AishuaiYao/AICleanBot/ROADMAP.md

# Roadmap

这个项目**没有做完**。V1 已经能跑，后续因为硬件资金等原因暂停。
路线图写在这里，任何一段都欢迎接手 —— 想认领请开一个 issue 说明你打算做哪块。

状态说明：✅ 已实现 · 🚧 进行中 · 📋 计划中 · 💭 构想

---

## V1 · 视觉巡线 ✅

目标：一块 ESP32-S3 独立完成「看线 → 沿走」。

- [x] OV2640 160×120 灰度采集，PSRAM 帧缓冲
- [x] ESP-DL 加载 INT8 模型，逐像素二分类
- [x] Sigmoid 查表后处理（256 项 LUT，零浮点）
- [x] 双质心 G1 / G2 提取，抗单点噪声
- [x] PID 差速控制，Kp 运行时可调
- [x] 连续丢线 5 帧自动停车
- [x] 编码器 PCNT 计数 + 滑动窗口掉速碰撞检测
- [x] 电池电压 ADC 采样
- [x] 呼吸灯状态指示
- [x] TCP 命令通道 + UDP 视频流
- [x] 实验模式：分割叠加图 + 遥测回传（19210B 定长帧）
- [x] 双分区 OTA 空中升级

**训练侧**

- [x] 完整数据采集 → 标注 → 划分 → 训练 → 量化 → 部署链路
- [x] 教师模型 U-Net + ResNet18
- [x] 学生模型 7 个变体（`UNetMiniExp1`~`7`）
- [x] 知识蒸馏（α=0.6, T=4.0）
- [x] ONNX 导出 + ESP-PPQ INT8 量化
- [x] 板端推理验证工具

**上位机**

- [x] 微信小程序：设备发现、握手、实时视频、遥控
- [x] 本地 / 云端数据集管理
- [x] 编码器数据记录与柱状图导出

---

## V1.1 · 清洁机构 ✅

- [x] 3 号电机独立 PWM 通道（GPIO45）
- [x] 毛刷 / 吸水辊结构
- [x] 水箱建模（`hardware/cad/water-tank.stl`）
- [x] 外壳、底盘结构件（毫米单位，可直接切片）

**遗留**

- [ ] 水箱水密性长期验证（PLA 会缓慢降解，需换 PETG 或涂层）
- [ ] 清洁电机的堵转保护

---

## V2 · 地图与导航 🚧

目标：从「跟着一条线走」升级到「知道自己在哪、还没扫过哪」。

- [ ] DFS 全覆盖遍历移植到板端 C++（原型：`py_scripts/simulation/dfs.py`）
- [ ] 栅格地图构建（10×10 → 可配置尺寸）
- [ ] 里程计：编码器 + 陀螺仪融合
- [ ] 路口识别（原型：`py_scripts/simulation/classification.py` 的端点扫描法）
- [ ] 回到未覆盖区域的重入策略

**难点**：双轮差速 + 单编码器一倍频的里程计漂移很大，需要引入 IMU 做融合。

---

## V3 · 自主清扫 📋

- [ ] 覆盖路径规划（弓字形 / 螺旋，按房间形状切换）
- [ ] 边界与悬崖检测
- [ ] 回充对接（红外 / 视觉）
- [ ] 清扫状态机：清扫 → 返回 → 充电 → 续扫
- [ ] 电量低自动返航

---

## V4 · 更强的 AI 💭

- [ ] 多类别分割：地面材质 / 障碍物 / 充电桩 / 地毯
- [ ] 端侧多任务模型（分割 + 分类共享 backbone）
- [ ] 自监督预训练，减少标注成本
- [ ] 模型热切换（不同地面用不同权重）

---

## 工程化 📋

这些不改变功能，但决定别人能不能顺利参与。

- [ ] WiFi SSID / 密码、PID 增益迁移到 `menuconfig`（`main/Kconfig.projbuild`）
- [ ] 模型改存 SPIFFS，换模型不用重新烧固件
- [ ] GitHub Actions：固件自动编译（多目标 esp32s3 / esp32p4）
- [ ] GitHub Actions：训练脚本冒烟测试（1 epoch 小数据集）
- [ ] 单元测试：`tools.py` 的路径处理、数据集划分
- [ ] 英文 README
- [ ] 拆解与装配视频教程

---

## 需要外部支持

| 需求 | 说明 |
|---|---|
| PCB 打样 / 贴片 | 现有载板工程见 `hardware/pcb/`，希望小型化并集成电机驱动 |
| 3D 打印 | 结构件迭代验证，尤其水箱密封 |
| 硬件测试 | 不同地面材质（瓷砖 / 木地板 / 地毯）的模型鲁棒性 |
| 算法 | 视觉里程计、全覆盖规划 |

如果你能提供其中任何一项，请开 issue 或直接联系仓库 owner。

---

## 不打算做的

明确划掉，避免有人白等：

- ❌ 云端推理（违背边缘计算初衷）
- ❌ 手机 App（小程序够用，且无需安装）
- ❌ 支持 ROS（资源开销与 ESP32-S3 不匹配）
- ❌ 激光雷达 SLAM（成本超过整机）
