AishuaiYao/AICleanBot/docs/assets/img/board-esp32s3cam.jpg

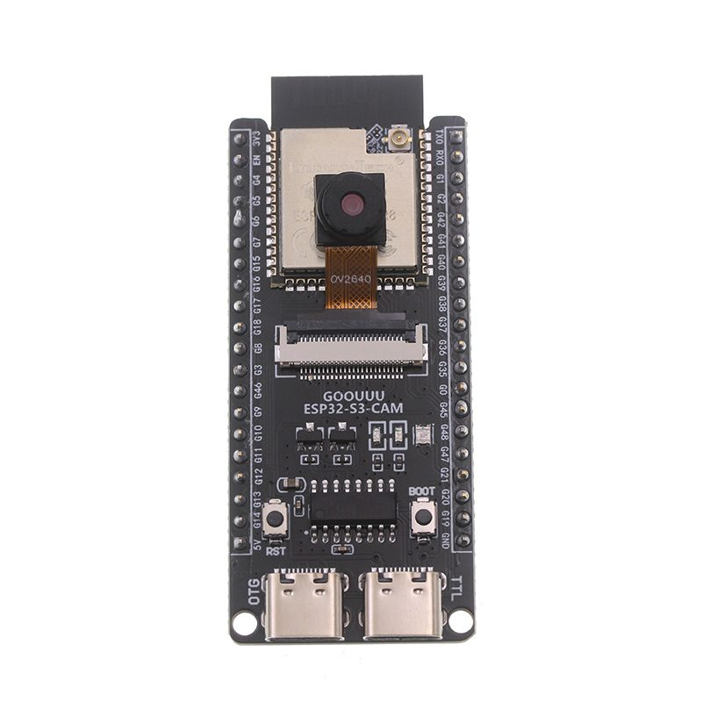
docs/assets/img/board-esp32s3cam.jpg
