AishuaiYao/AICleanBot/docs/assets/img/concept-1.jpg

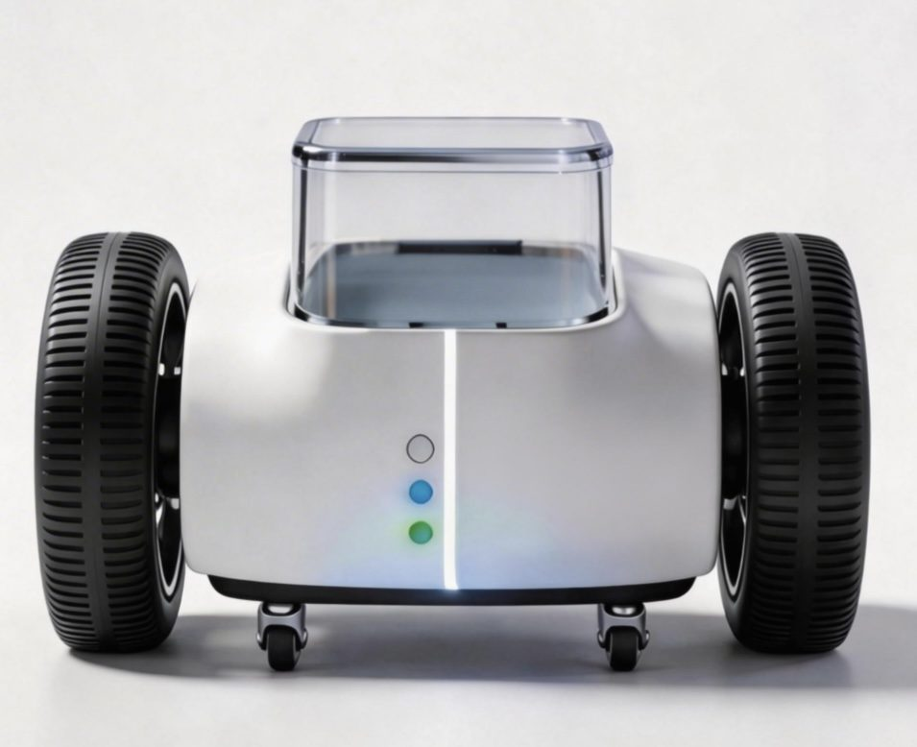
docs/assets/img/concept-1.jpg
