AishuaiYao/AICleanBot/docs/assets/img/concept-3.jpg

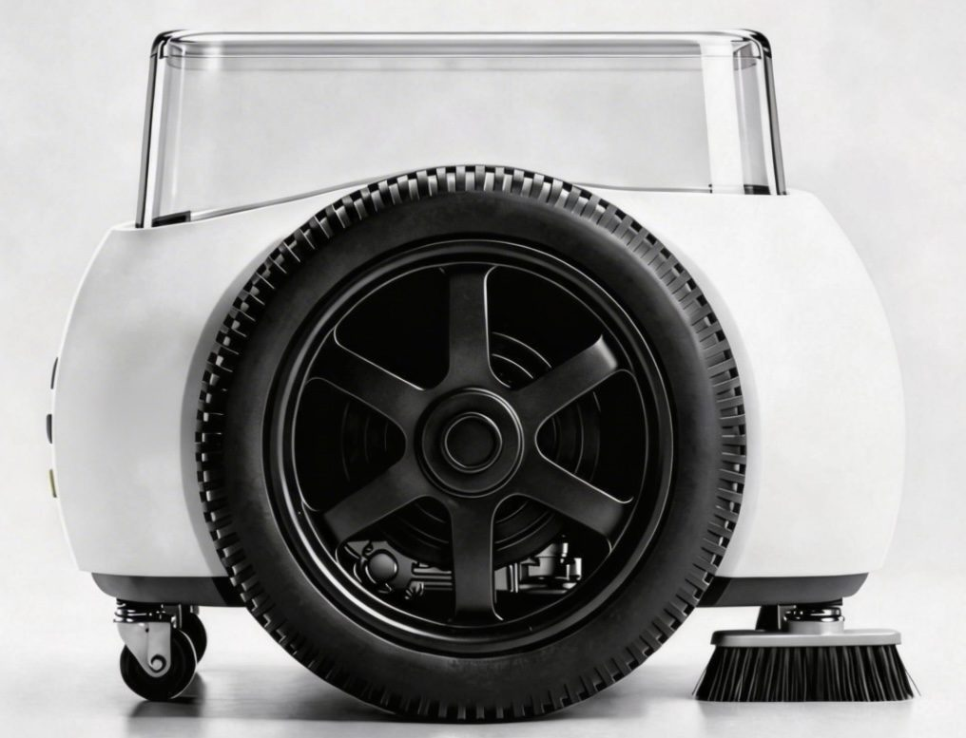
docs/assets/img/concept-3.jpg
