AishuaiYao/AICleanBot/docs/assets/img/render-bottom.jpg

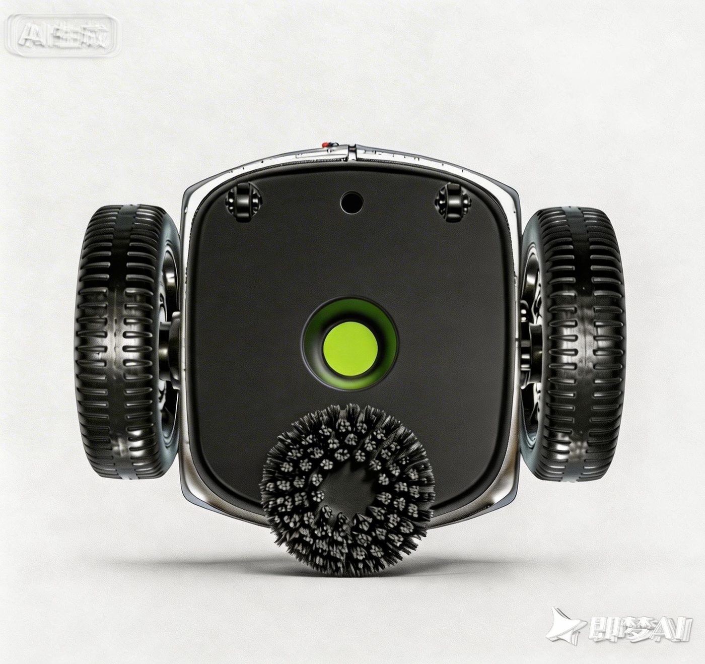
docs/assets/img/render-bottom.jpg
