AishuaiYao/AICleanBot/docs/assets/img/render-perspective-1.jpg

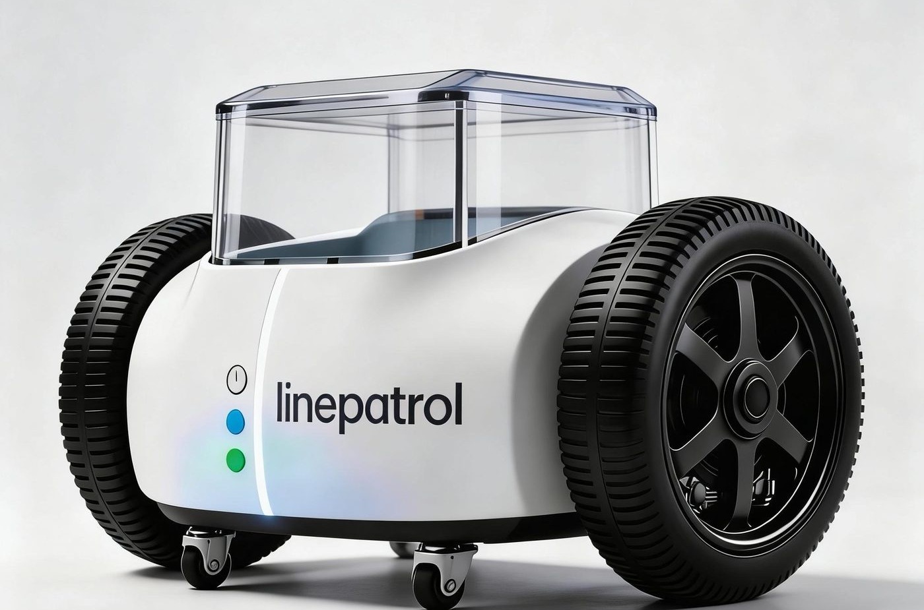
docs/assets/img/render-perspective-1.jpg
