AishuaiYao/AICleanBot/docs/assets/img/render-right.jpg

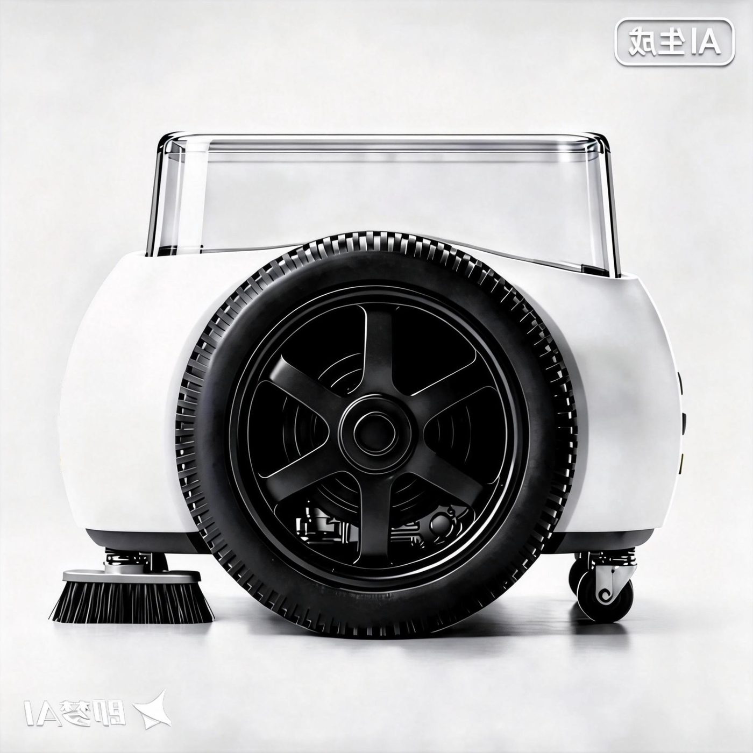
docs/assets/img/render-right.jpg
