AishuaiYao/AICleanBot/docs/assets/img/ui-3.jpg

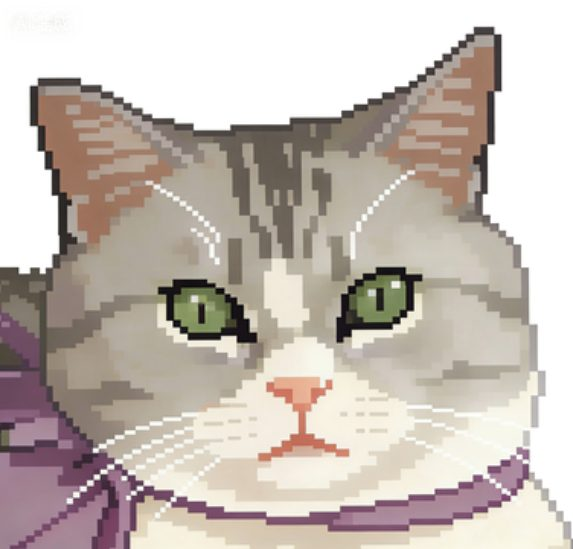
docs/assets/img/ui-3.jpg
