AishuaiYao/AICleanBot/hardware/photos/board-dimensions.jpg

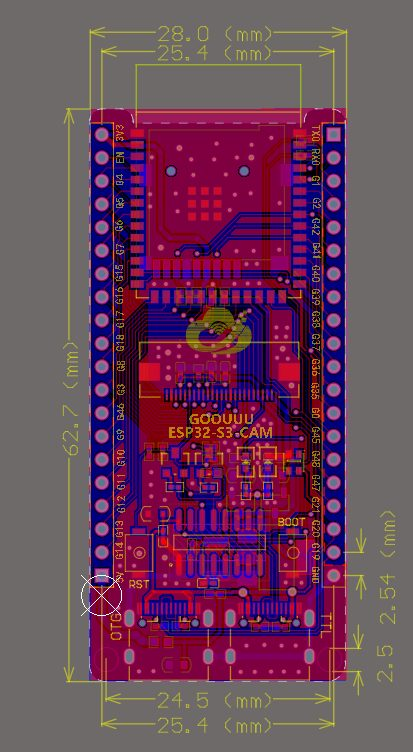
hardware/photos/board-dimensions.jpg
