AishuaiYao/AICleanBot/hardware/photos/board-pinout.jpg

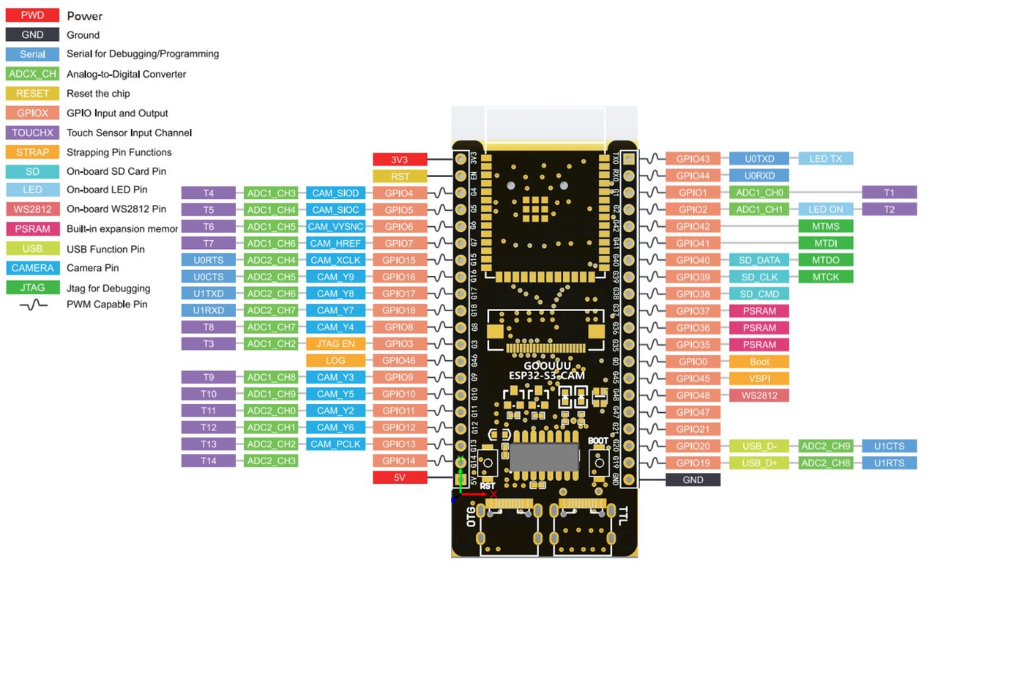
hardware/photos/board-pinout.jpg
