AishuaiYao/AICleanBot/hardware/photos/concept-7.jpg

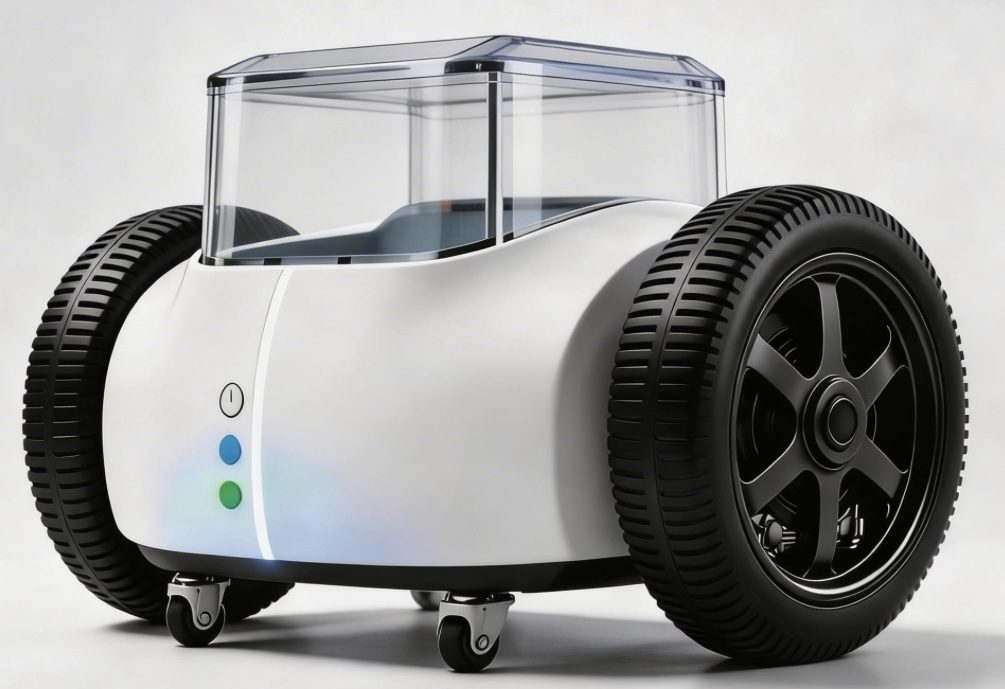
hardware/photos/concept-7.jpg
