AishuaiYao/AICleanBot/hardware/photos/concept-8.jpg

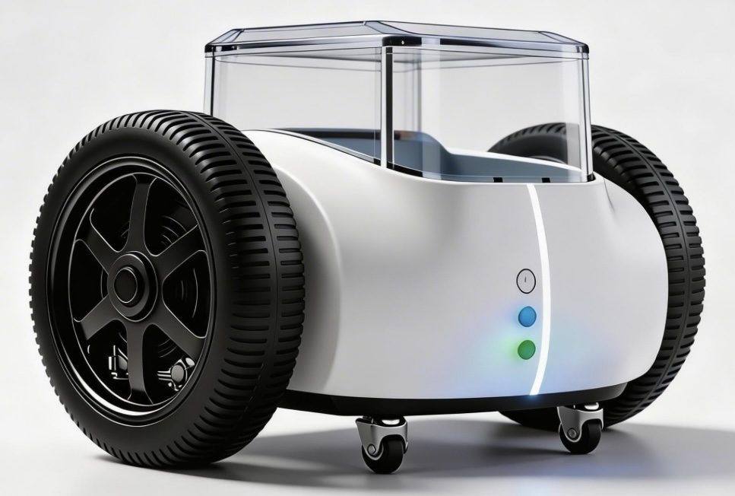
hardware/photos/concept-8.jpg
