AishuaiYao/AICleanBot/hardware/photos/render-back.jpg

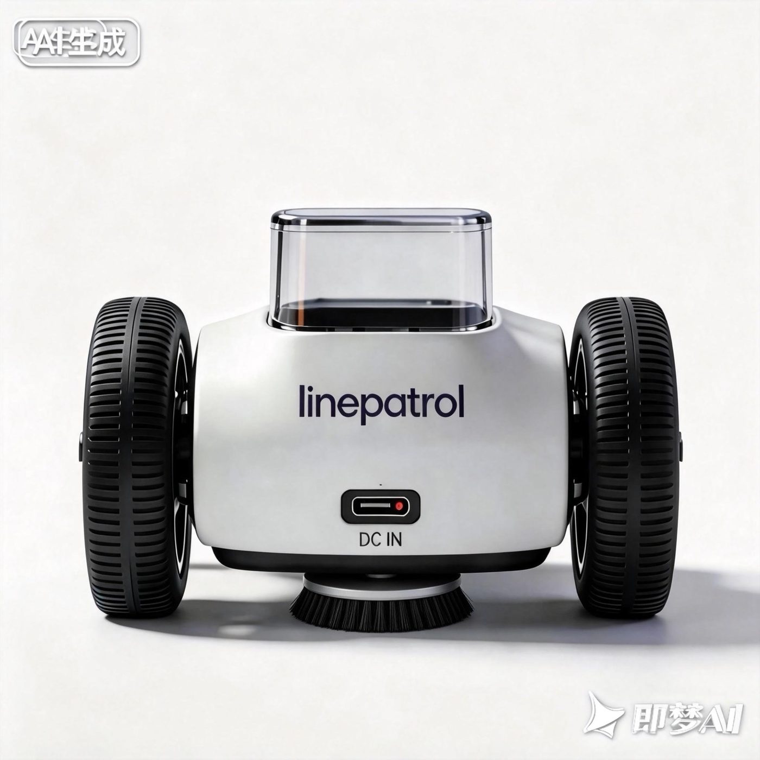
hardware/photos/render-back.jpg
