AishuaiYao/AICleanBot/hardware/photos/render-left.jpg

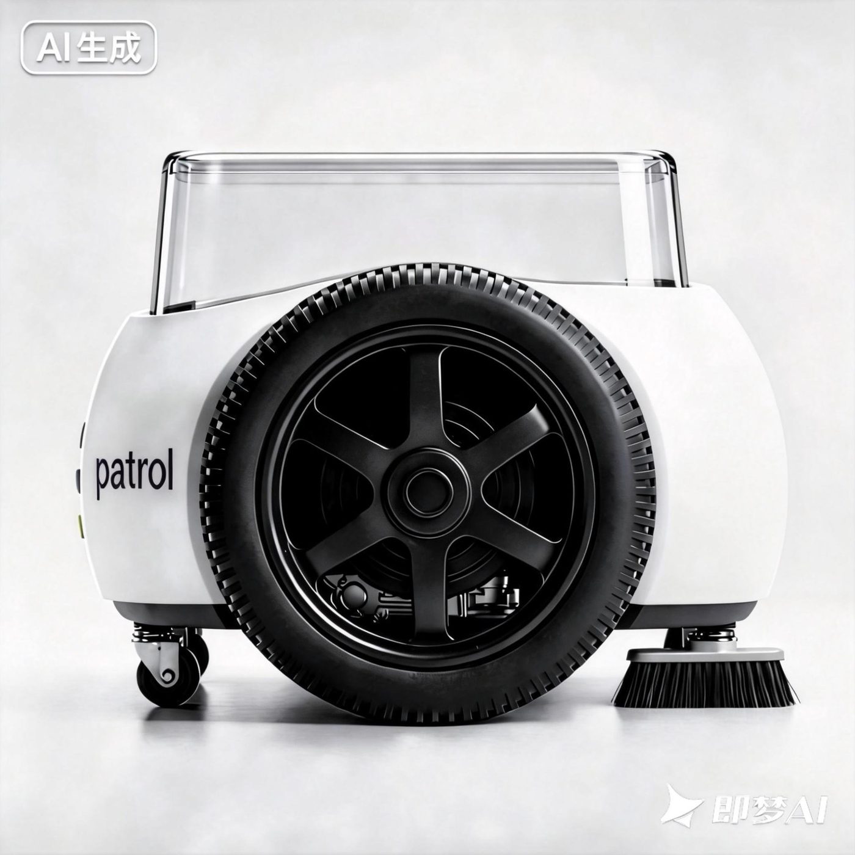
hardware/photos/render-left.jpg
