AishuaiYao/AICleanBot/hardware/photos/sketch-1.jpg

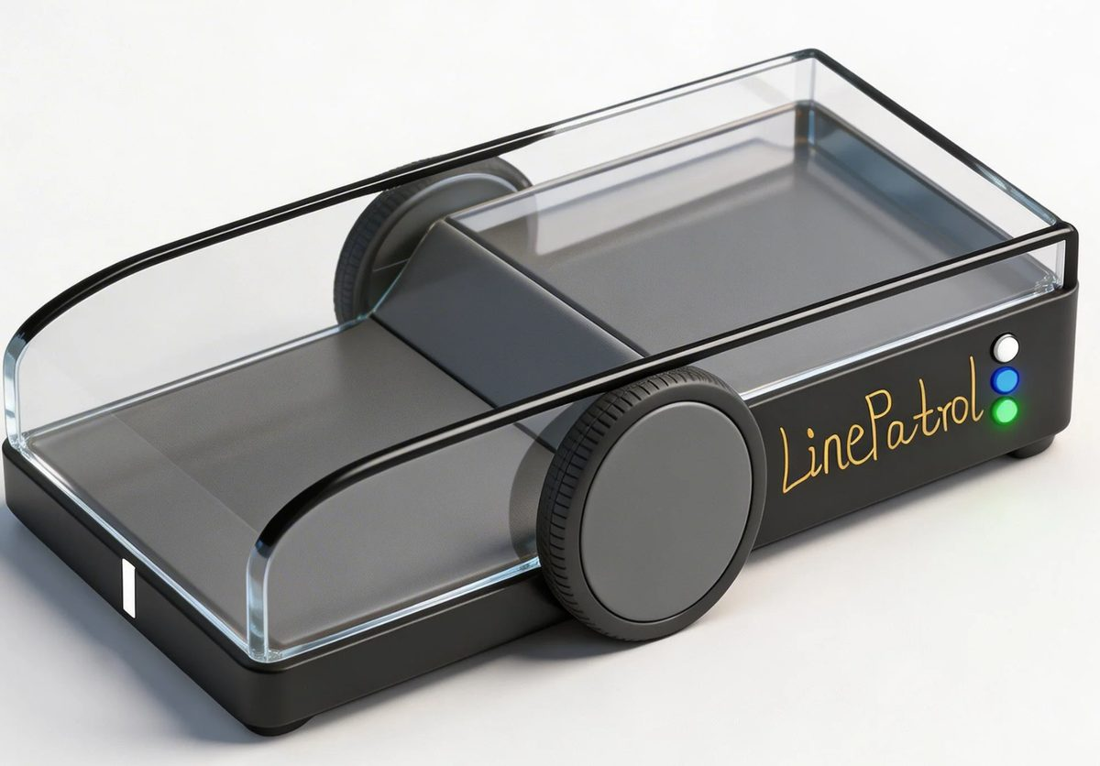
hardware/photos/sketch-1.jpg
