AishuaiYao/AICleanBot/hardware/photos/sketch-2.jpg

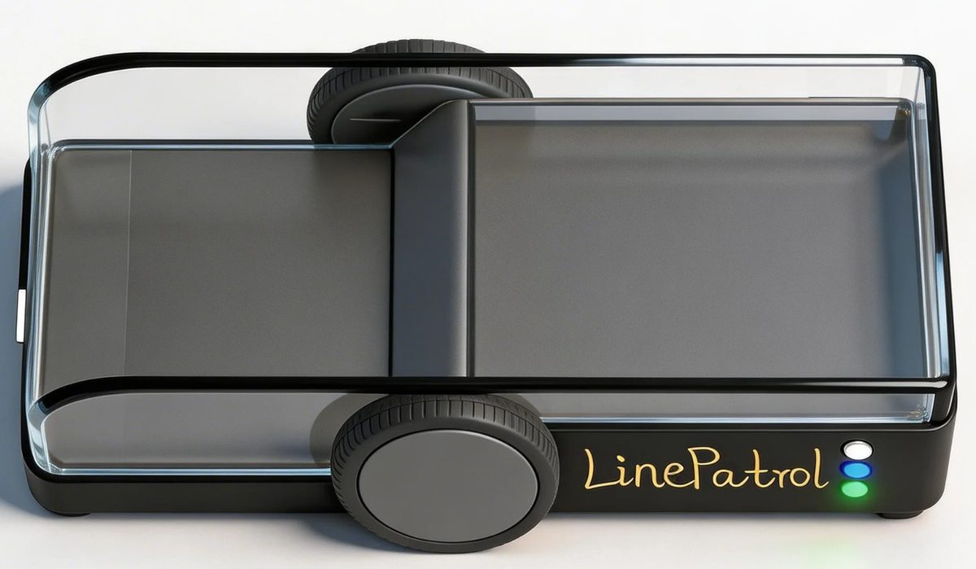
hardware/photos/sketch-2.jpg
