AishuaiYao/AICleanBot/hardware/photos/sketch-bottom.jpg

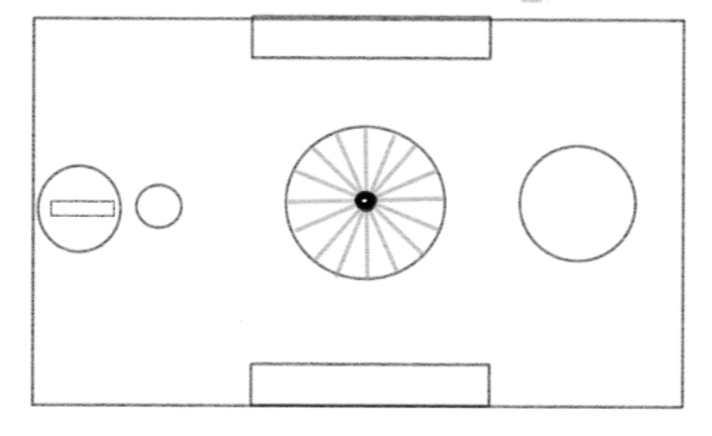
hardware/photos/sketch-bottom.jpg
