AishuaiYao/AICleanBot/hardware/photos/sketch-side.jpg

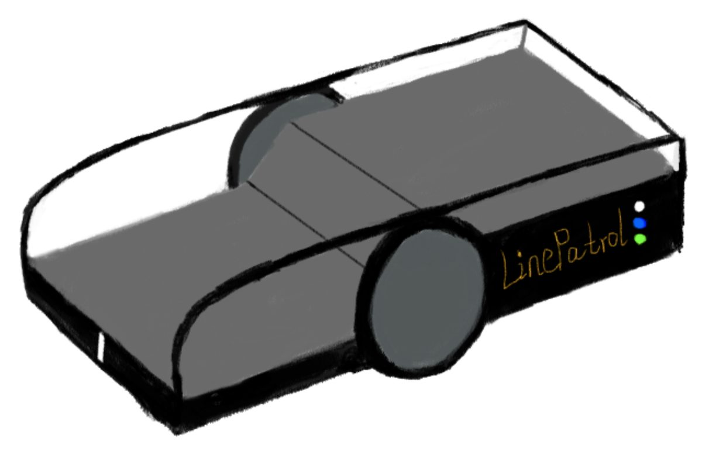
hardware/photos/sketch-side.jpg
