AishuaiYao/AICleanBot/hardware/photos/ui-4.jpg

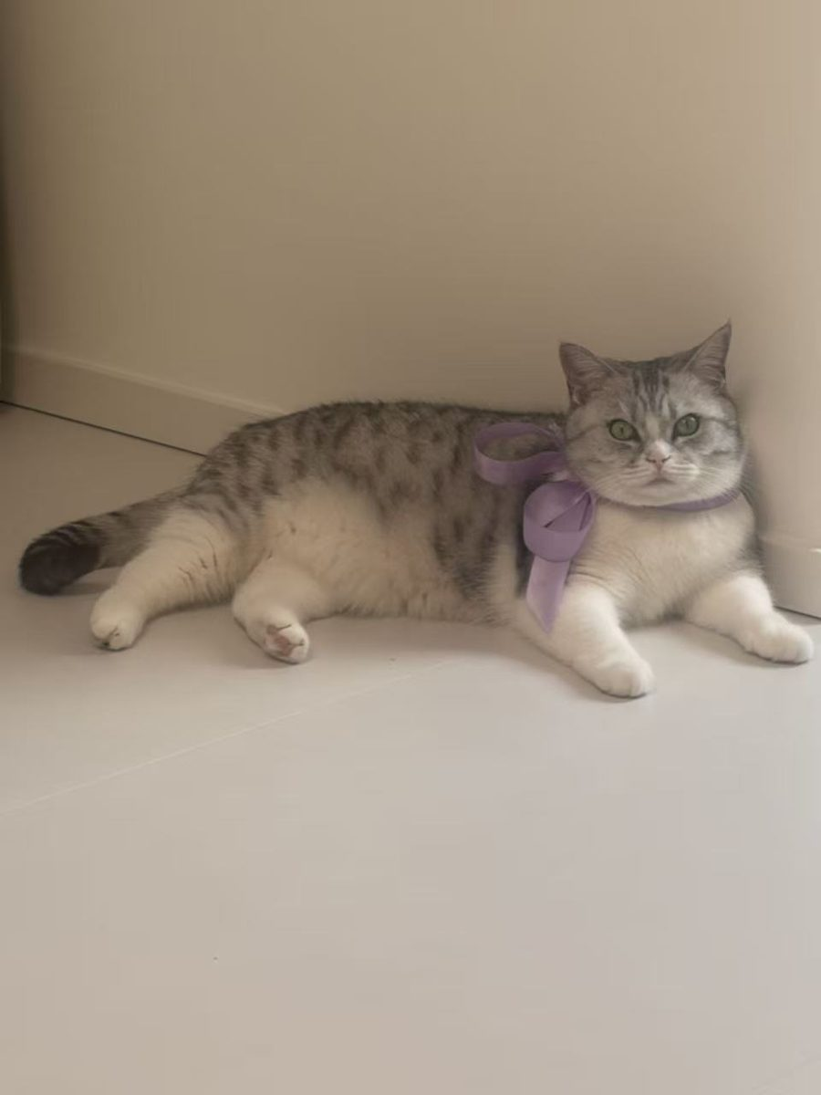
hardware/photos/ui-4.jpg
