AishuaiYao/AICleanBot/hardware/photos/ui-5.jpg

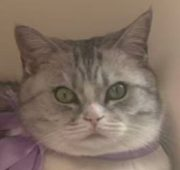
hardware/photos/ui-5.jpg
