AishuaiYao/AICleanBot/py_scripts/dataset/val/images/00002.png

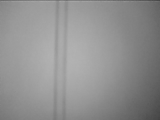
py_scripts/dataset/val/images/00002.png
