AishuaiYao/AICleanBot/py_scripts/dataset/val/images/00008.png

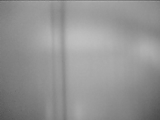
py_scripts/dataset/val/images/00008.png
