AishuaiYao/AICleanBot/py_scripts/dataset/val/images/00009.png

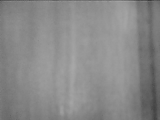
py_scripts/dataset/val/images/00009.png
