AishuaiYao/AICleanBot/py_scripts/dataset/val/images/00023.png

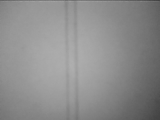
py_scripts/dataset/val/images/00023.png
