AishuaiYao/AICleanBot/py_scripts/dataset/val/images/00365.png

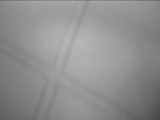
py_scripts/dataset/val/images/00365.png
