AishuaiYao/AICleanBot/py_scripts/dataset/val/images/00419.png

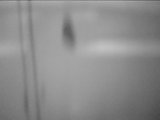
py_scripts/dataset/val/images/00419.png
