AishuaiYao/AICleanBot/py_scripts/dataset/val/images/00424.png

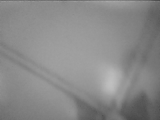
py_scripts/dataset/val/images/00424.png
