AishuaiYao/AICleanBot/py_scripts/dataset/val/images/00439.png

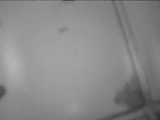
py_scripts/dataset/val/images/00439.png
