AishuaiYao/AICleanBot/py_scripts/dataset/val/images/00545.png

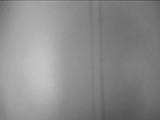
py_scripts/dataset/val/images/00545.png
