AishuaiYao/AICleanBot/py_scripts/dataset/val/images/00595.png

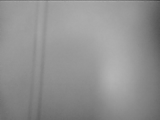
py_scripts/dataset/val/images/00595.png
