AishuaiYao/AICleanBot/py_scripts/dataset/val/labels/00002.png

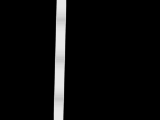
py_scripts/dataset/val/labels/00002.png
