AishuaiYao/AICleanBot/py_scripts/dataset/val/labels/00007.png

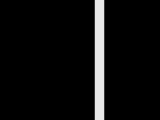
py_scripts/dataset/val/labels/00007.png
