AishuaiYao/AICleanBot/py_scripts/dataset/val/labels/00009.png

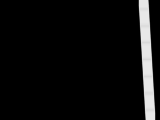
py_scripts/dataset/val/labels/00009.png
