AishuaiYao/AICleanBot/py_scripts/dataset/val/labels/00023.png

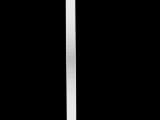
py_scripts/dataset/val/labels/00023.png
