AishuaiYao/AICleanBot/py_scripts/dataset/val/labels/00024.png

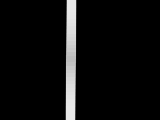
py_scripts/dataset/val/labels/00024.png
