AishuaiYao/AICleanBot/py_scripts/dataset/val/labels/00174.png

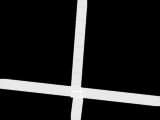
py_scripts/dataset/val/labels/00174.png
