AishuaiYao/AICleanBot/py_scripts/dataset/val/labels/00208.png

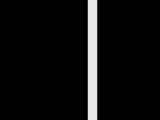
py_scripts/dataset/val/labels/00208.png
