AishuaiYao/AICleanBot/py_scripts/dataset/val/labels/00315.png

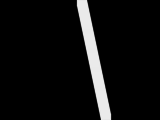
py_scripts/dataset/val/labels/00315.png
