AishuaiYao/AICleanBot/py_scripts/dataset/val/labels/00368.png

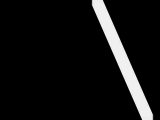
py_scripts/dataset/val/labels/00368.png
