AishuaiYao/AICleanBot/py_scripts/dataset/val/labels/00419.png

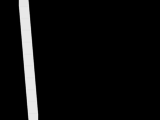
py_scripts/dataset/val/labels/00419.png
