AishuaiYao/AICleanBot/py_scripts/dataset/val/labels/00560.png

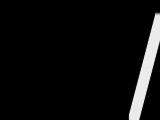
py_scripts/dataset/val/labels/00560.png
