AishuaiYao/AICleanBot/py_scripts/dataset/val/labels/00566.png

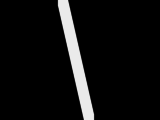
py_scripts/dataset/val/labels/00566.png
