AishuaiYao/AICleanBot/py_scripts/dataset/val/labels/00567.png

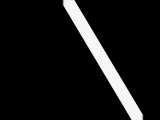
py_scripts/dataset/val/labels/00567.png
