AishuaiYao/AICleanBot/py_scripts/dataset/val/labels/00594.png

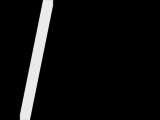
py_scripts/dataset/val/labels/00594.png
