AishuaiYao/AICleanBot/py_scripts/figure/1 copy 2_overview.png

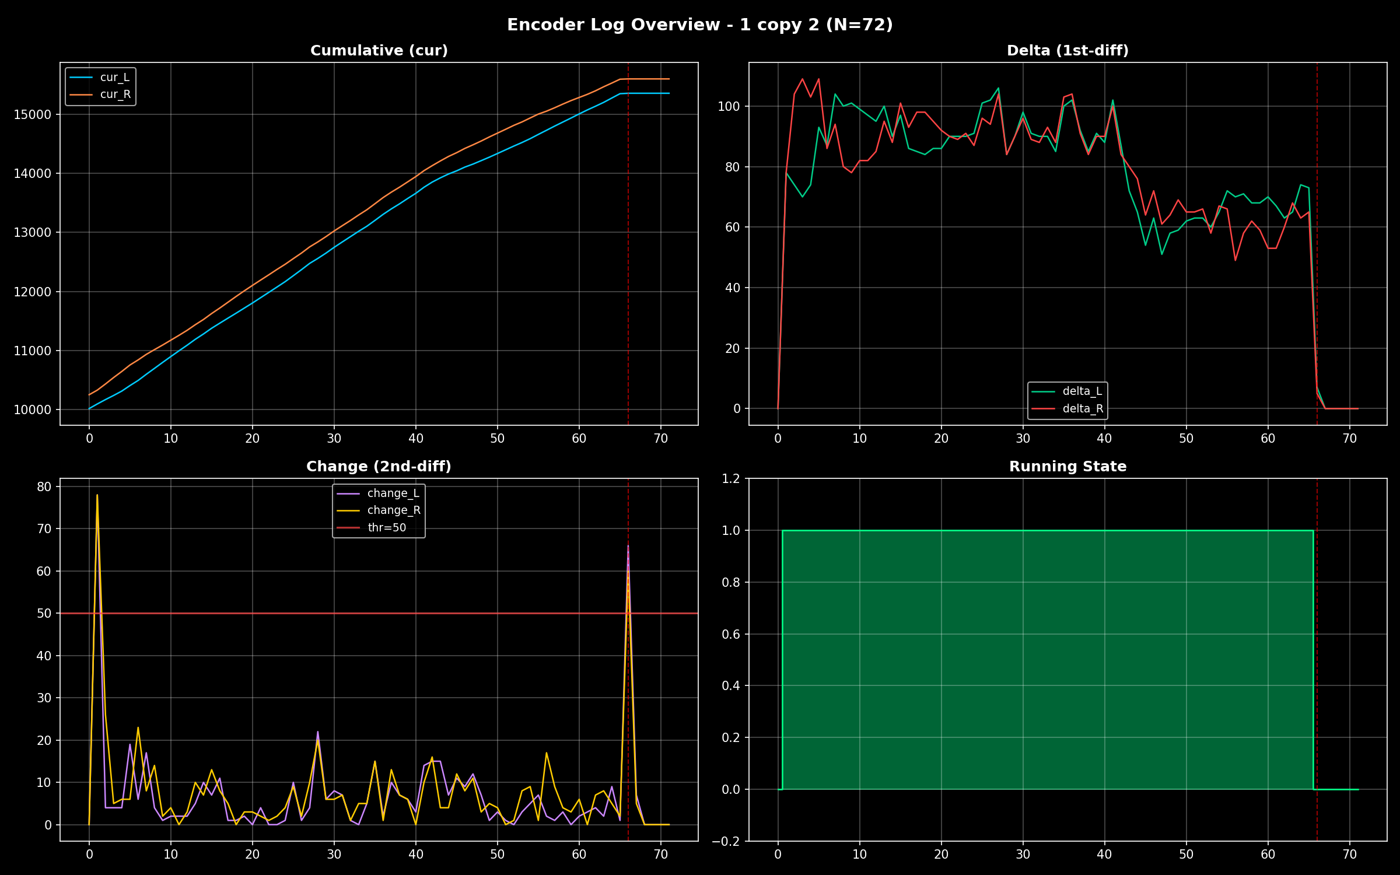
py_scripts/figure/1 copy 2_overview.png
