AishuaiYao/AICleanBot/py_scripts/figure/1 copy 3_overview.png

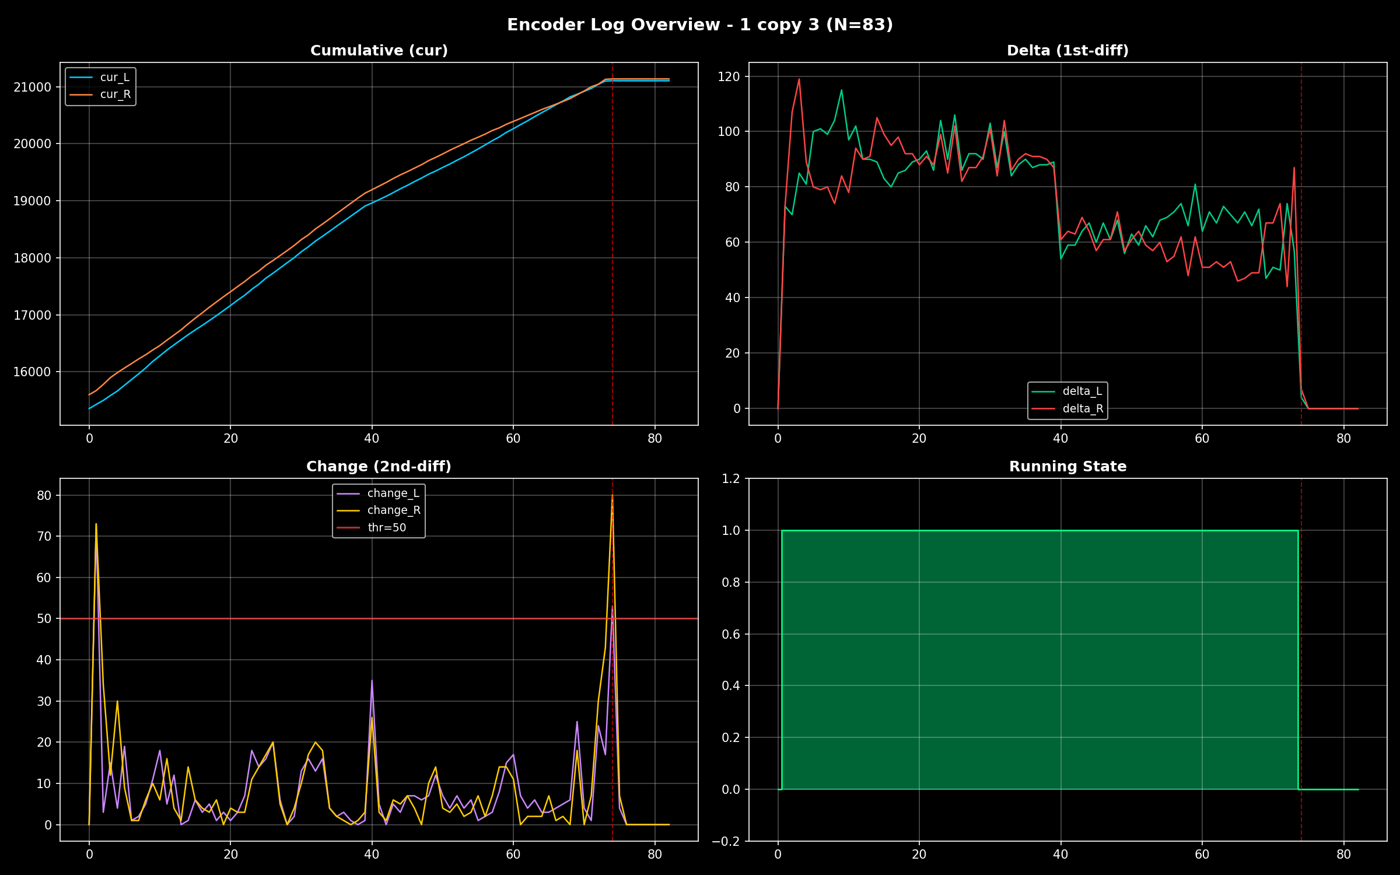
py_scripts/figure/1 copy 3_overview.png
