AishuaiYao/AICleanBot/py_scripts/figure/1 copy 4_overview.png

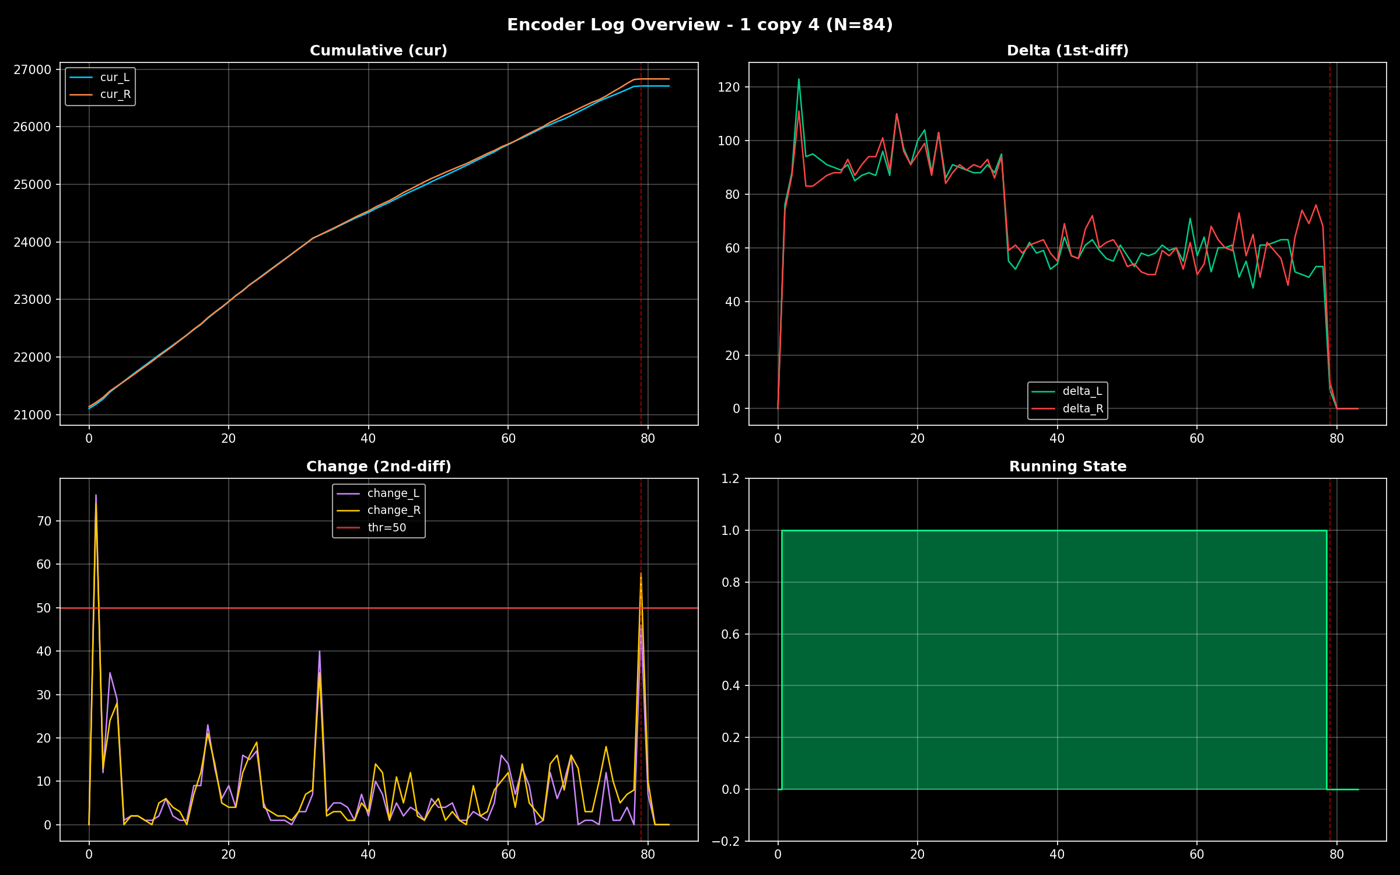
py_scripts/figure/1 copy 4_overview.png
