AishuaiYao/AICleanBot/py_scripts/figure/1 copy_overview.png

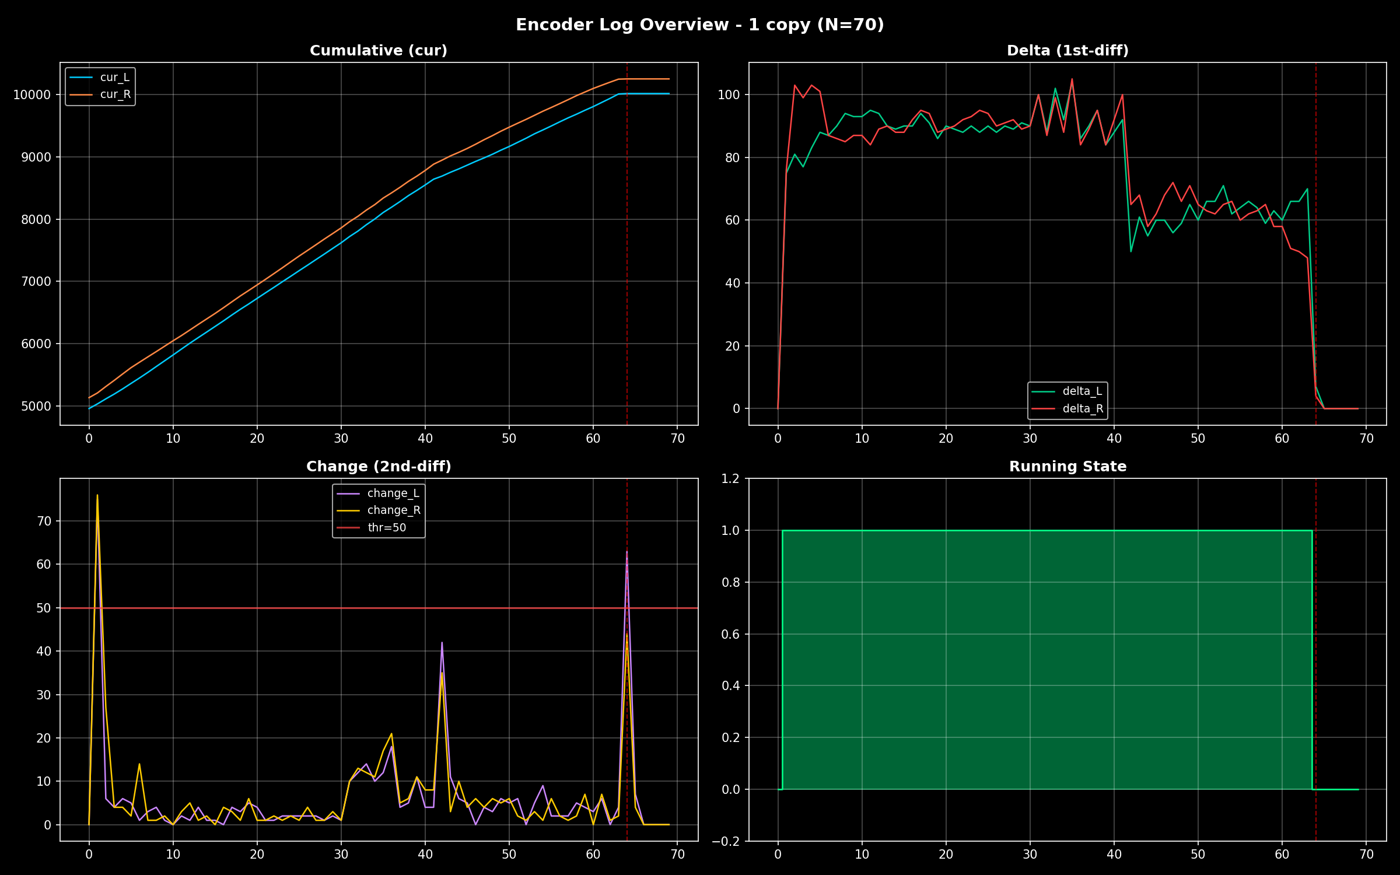
py_scripts/figure/1 copy_overview.png
