AishuaiYao/AICleanBot/py_scripts/figure/1_overview.png

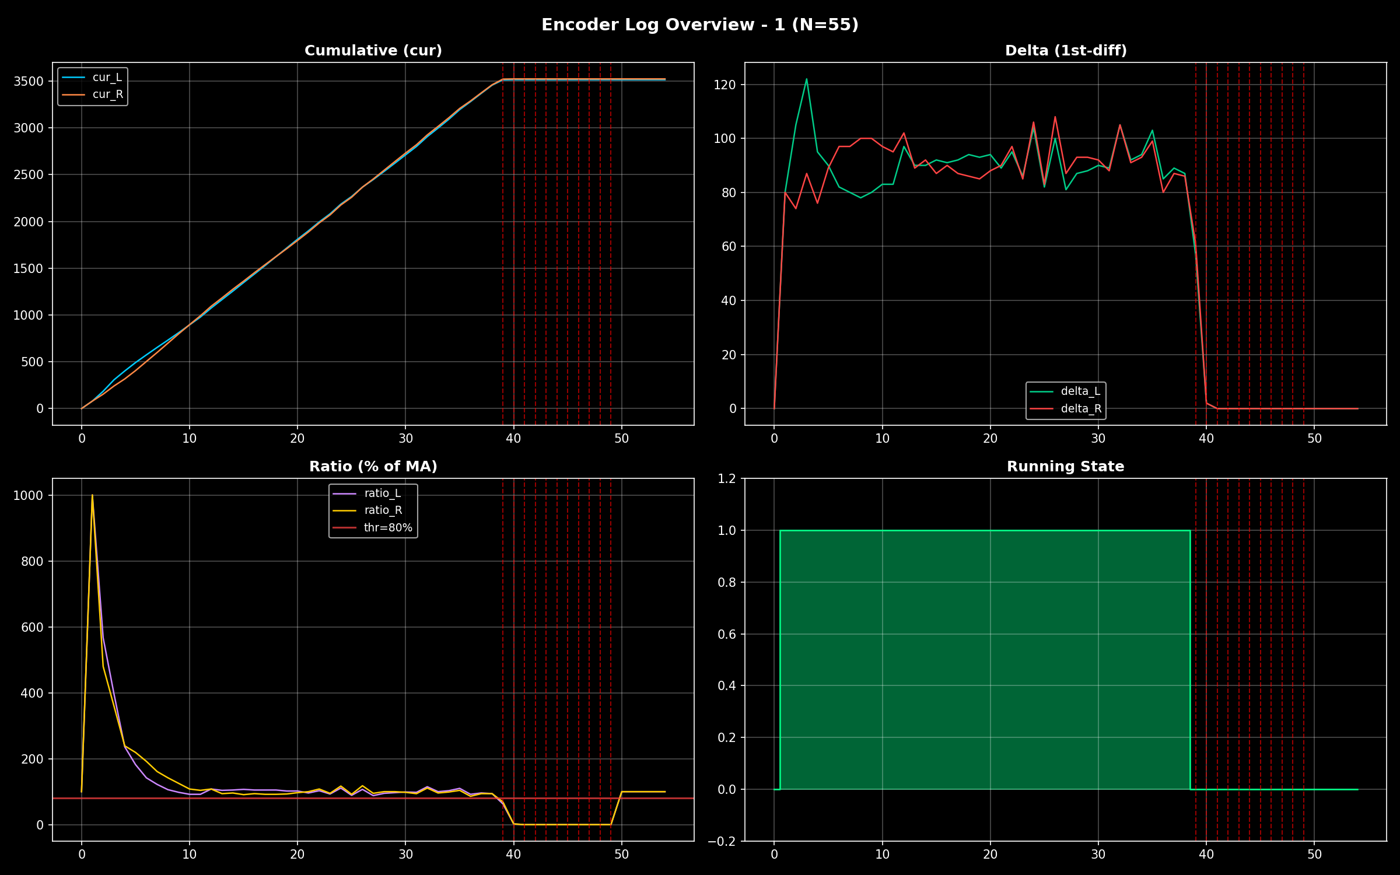
py_scripts/figure/1_overview.png
