AishuaiYao/AICleanBot/py_scripts/figure/2_overview.png

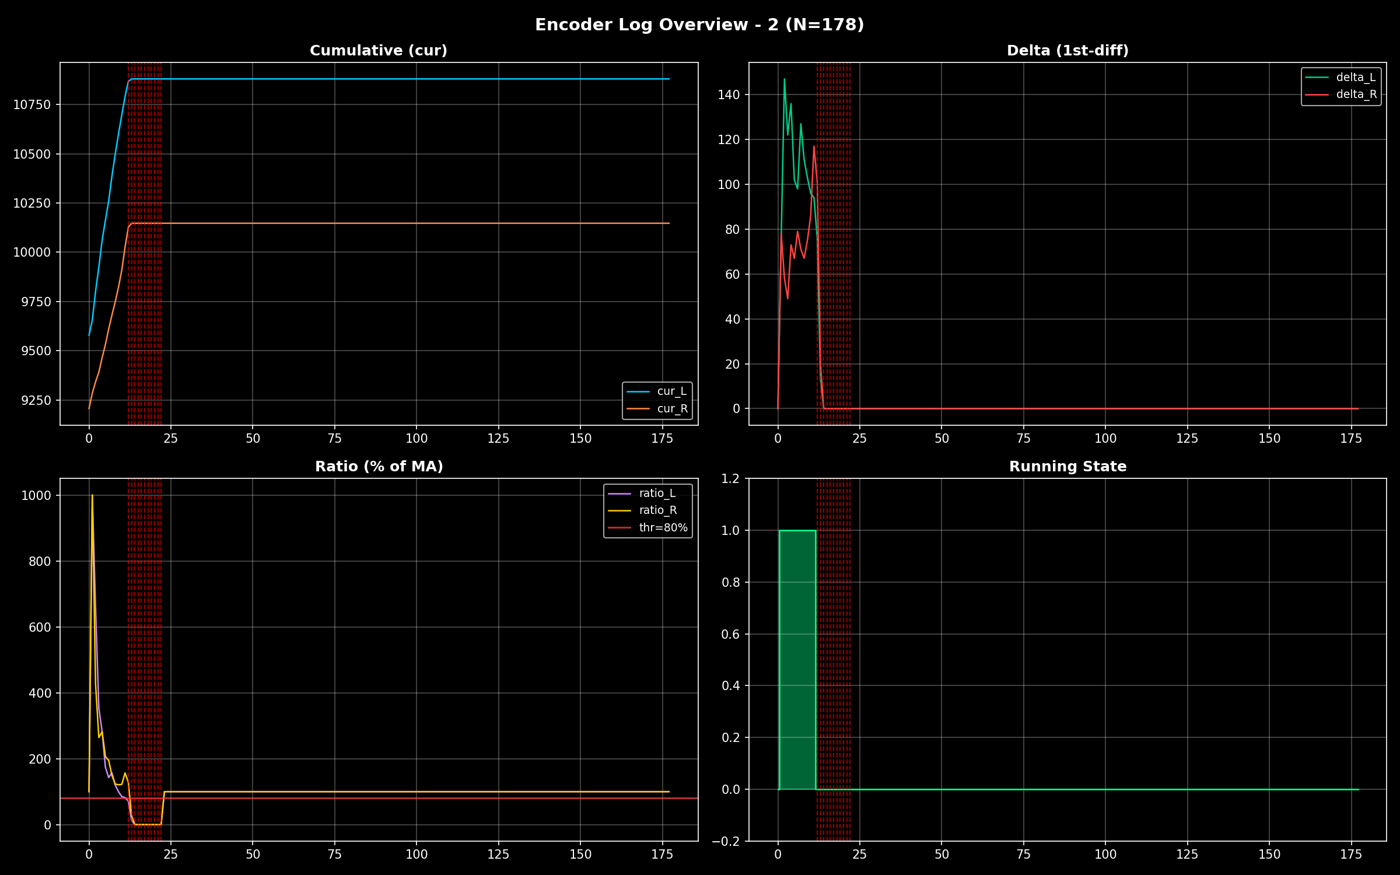
py_scripts/figure/2_overview.png
