AishuaiYao/AICleanBot/py_scripts/figure/4_overview.png

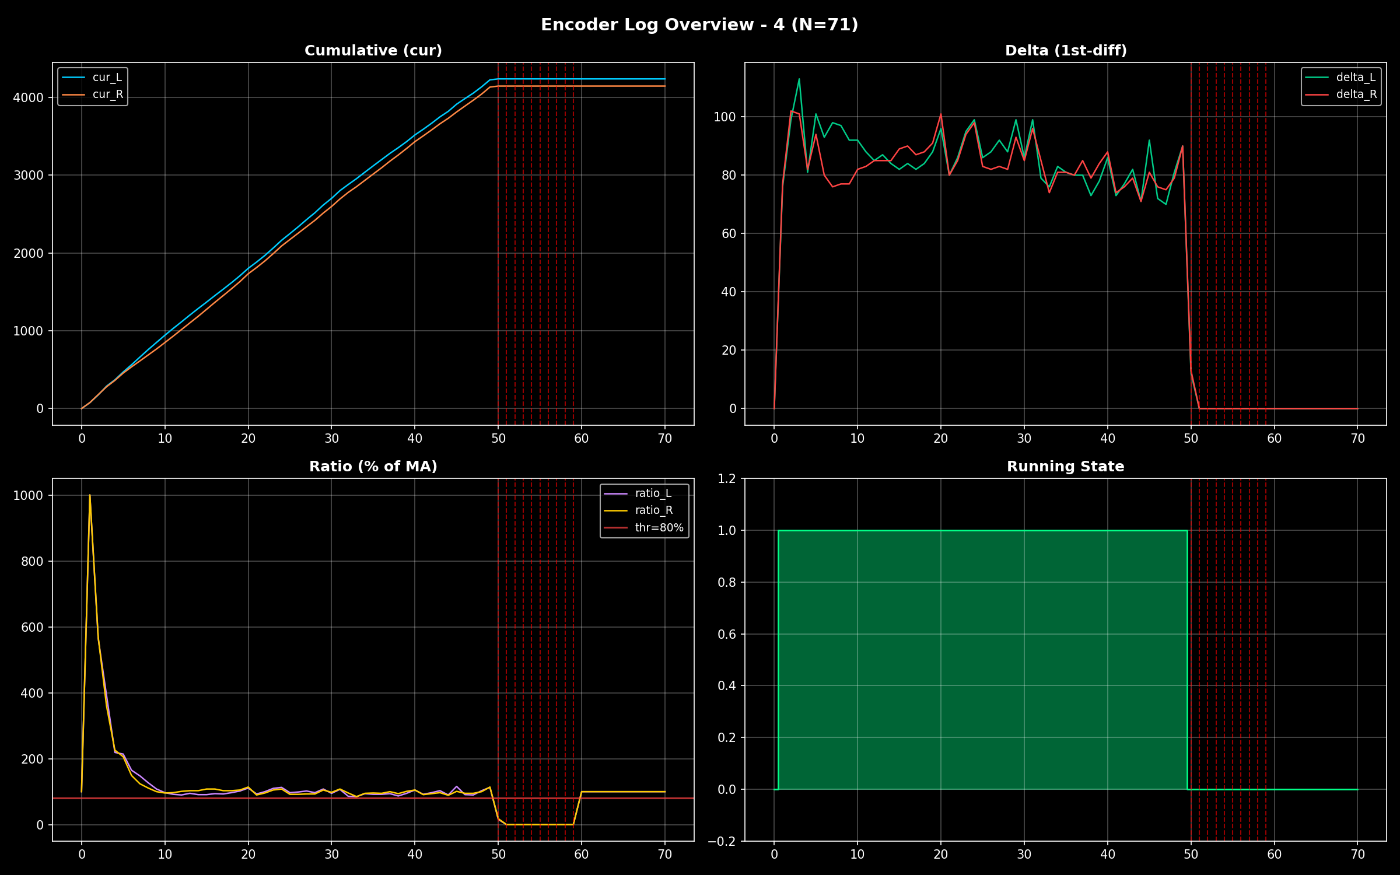
py_scripts/figure/4_overview.png
