AishuaiYao/AICleanBot/py_scripts/figure/20260412_173751_UNetMiniExp5/training_curves.png

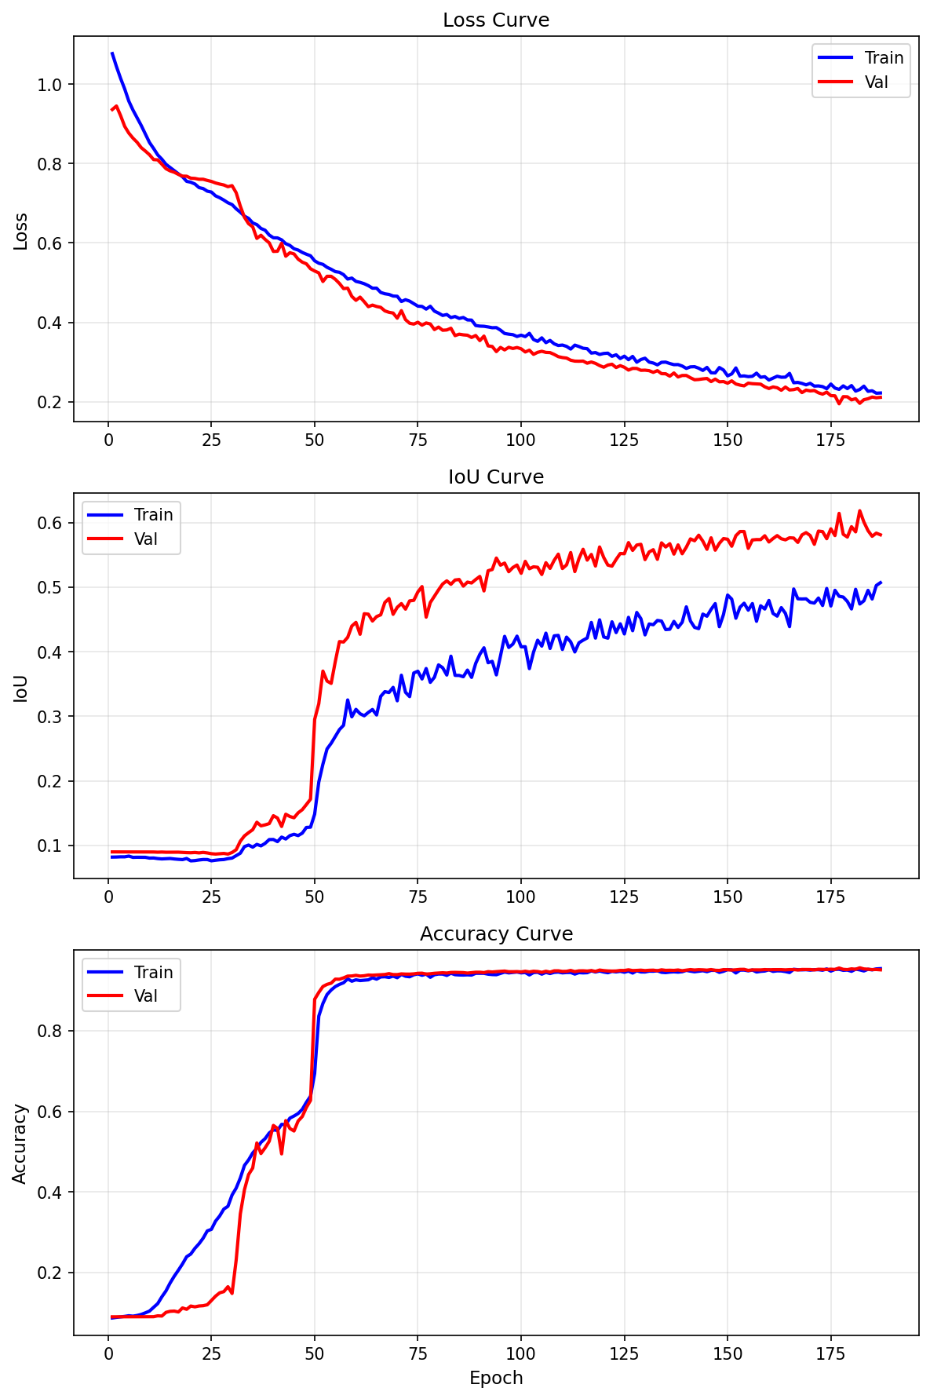
py_scripts/figure/20260412_173751_UNetMiniExp5/training_curves.png
