AishuaiYao/AICleanBot/py_scripts/figure/20260413_224444_UNetMiniExp5/training_curves.png

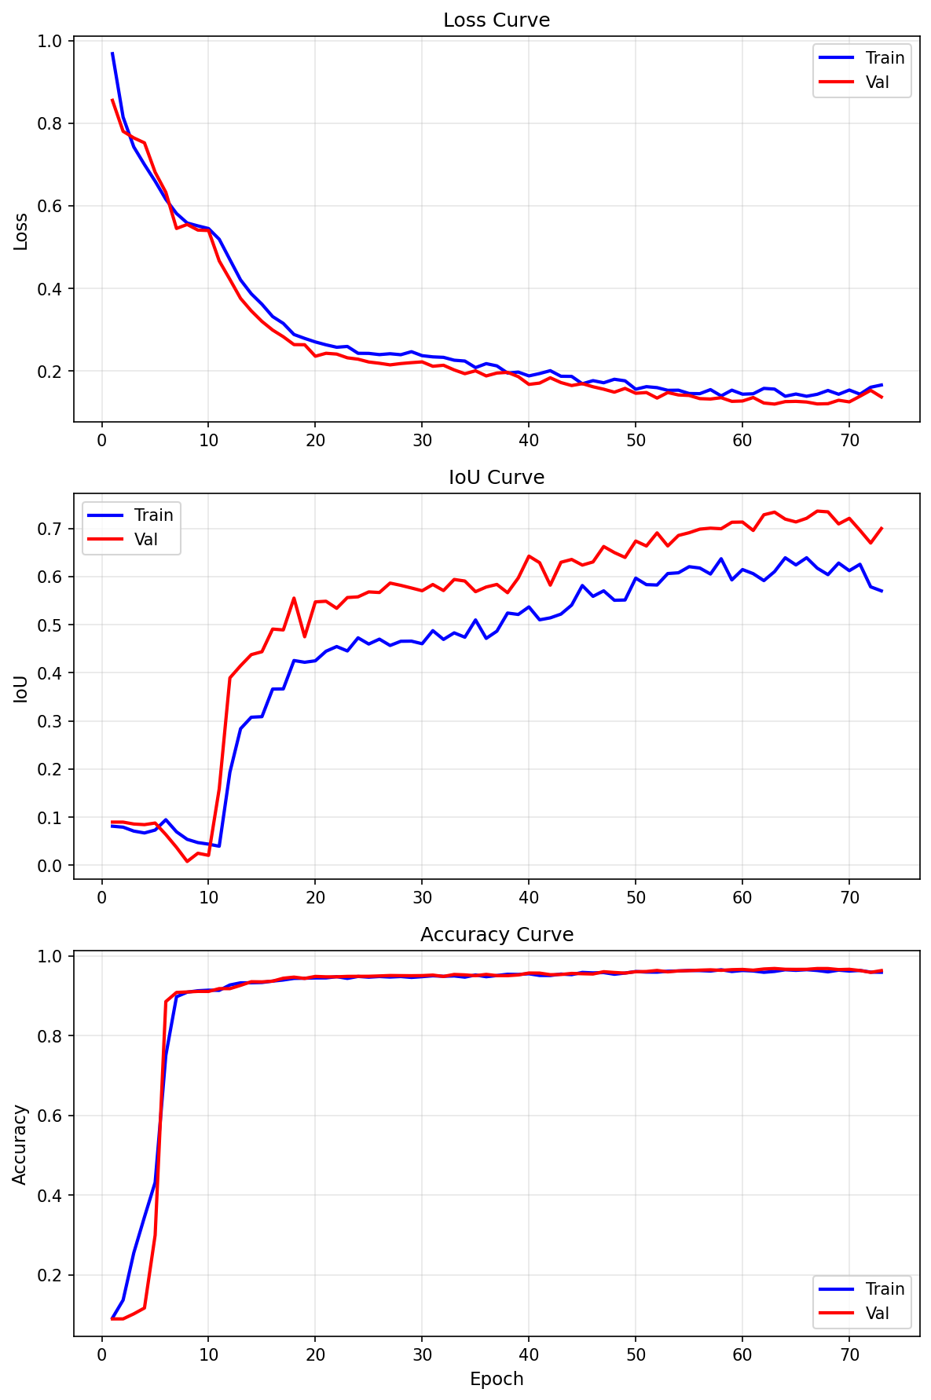
py_scripts/figure/20260413_224444_UNetMiniExp5/training_curves.png
