AishuaiYao/AICleanBot/py_scripts/figure/20260414_091019_UNetMiniExp5/training_curves.png

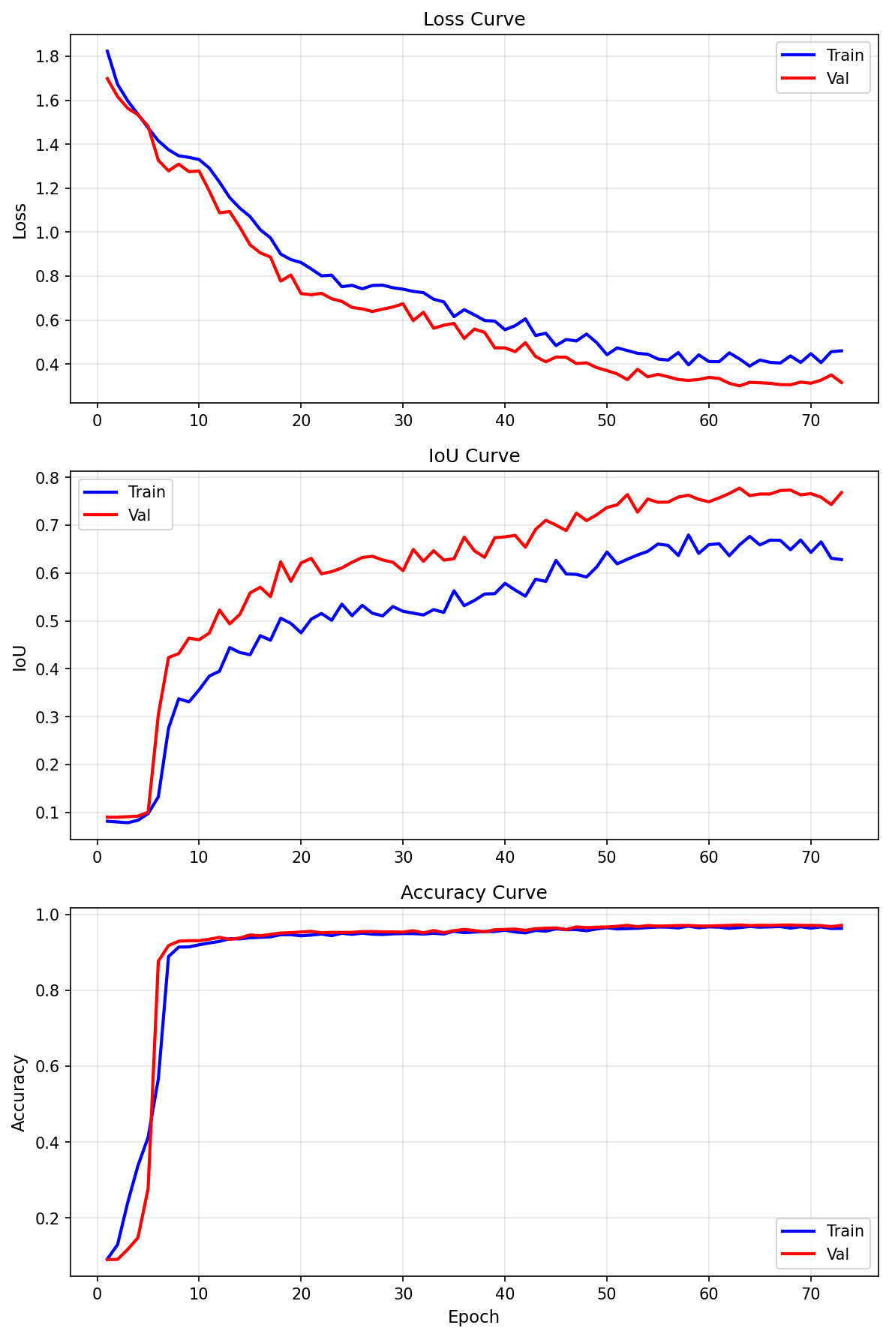
py_scripts/figure/20260414_091019_UNetMiniExp5/training_curves.png
