AishuaiYao/AICleanBot/py_scripts/figure/20260415_215136_UNetMiniExp5/training_curves.png

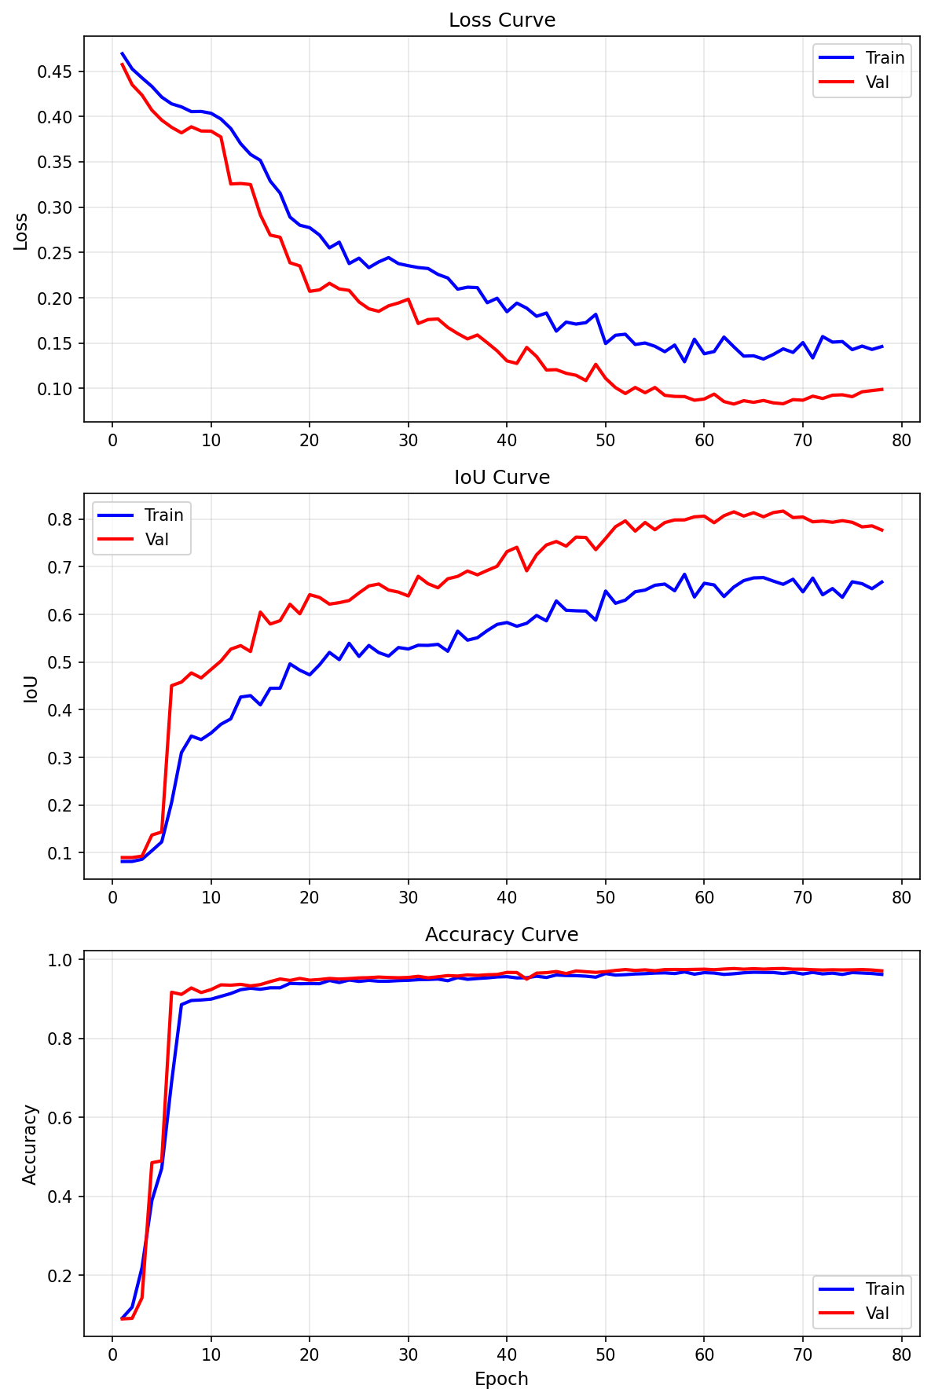
py_scripts/figure/20260415_215136_UNetMiniExp5/training_curves.png
