AishuaiYao/AICleanBot/py_scripts/figure/20260416_090153_UNet_ResNet18/training_curves.png

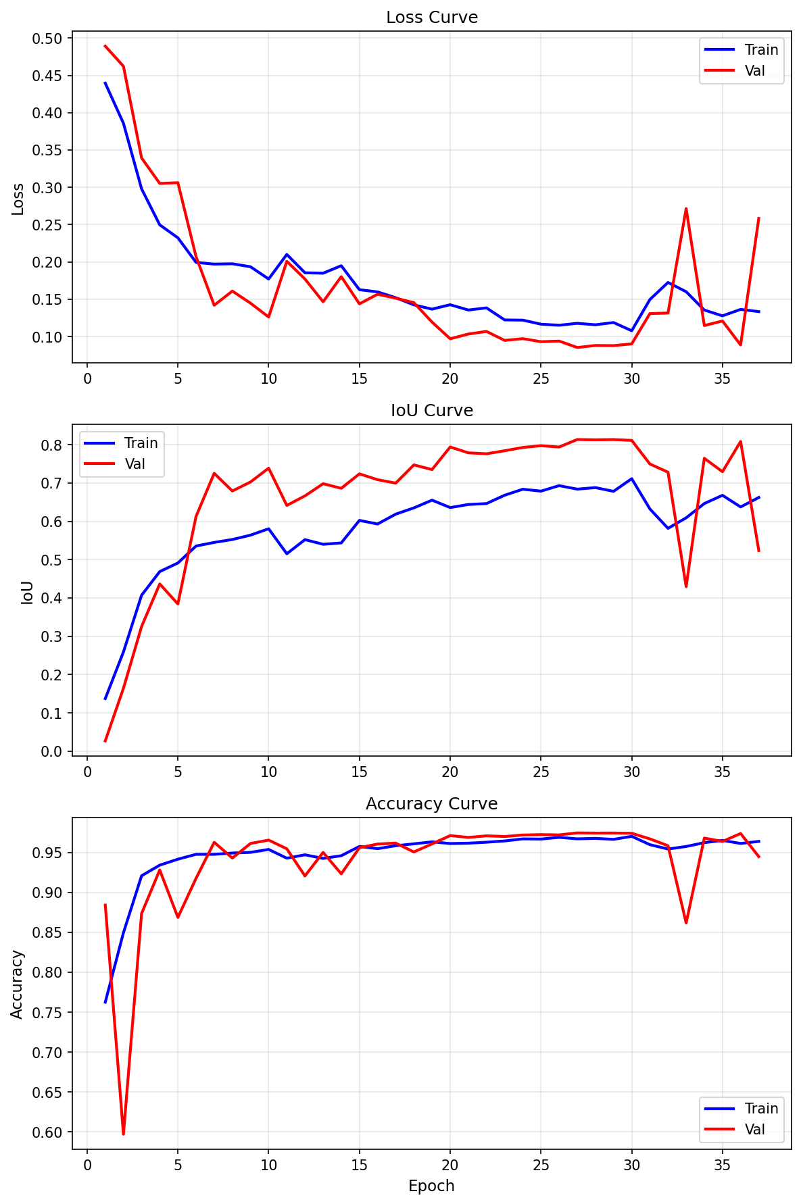
py_scripts/figure/20260416_090153_UNet_ResNet18/training_curves.png
