AishuaiYao/AICleanBot/py_scripts/figure/20260416_090724_UNet_ResNet18/training_curves.png

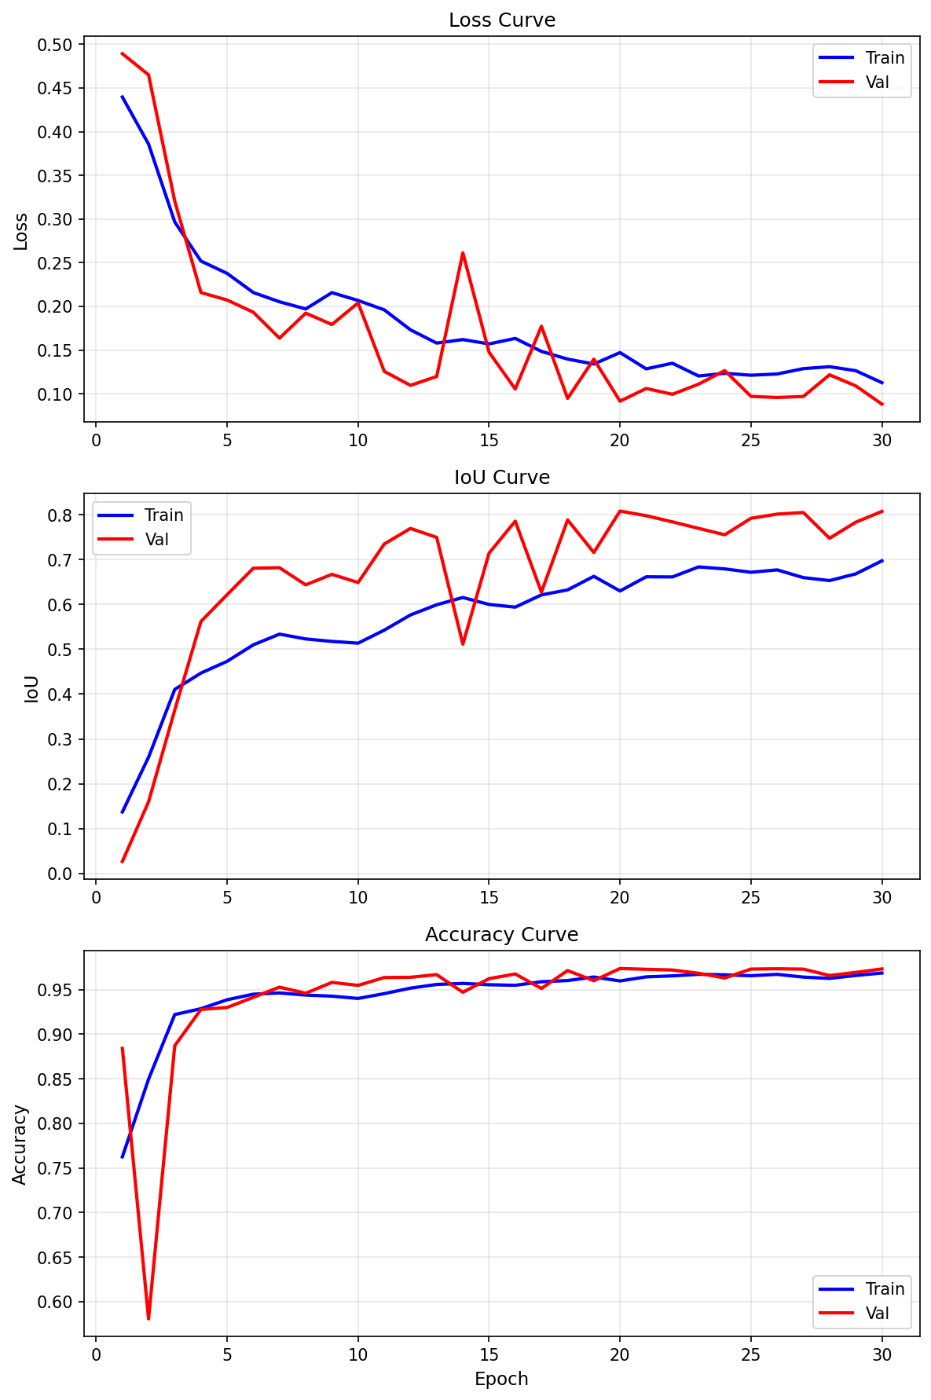
py_scripts/figure/20260416_090724_UNet_ResNet18/training_curves.png
