AishuaiYao/AICleanBot/py_scripts/figure/20260416_223257_UNetMiniExp5_KD/training_curves.png

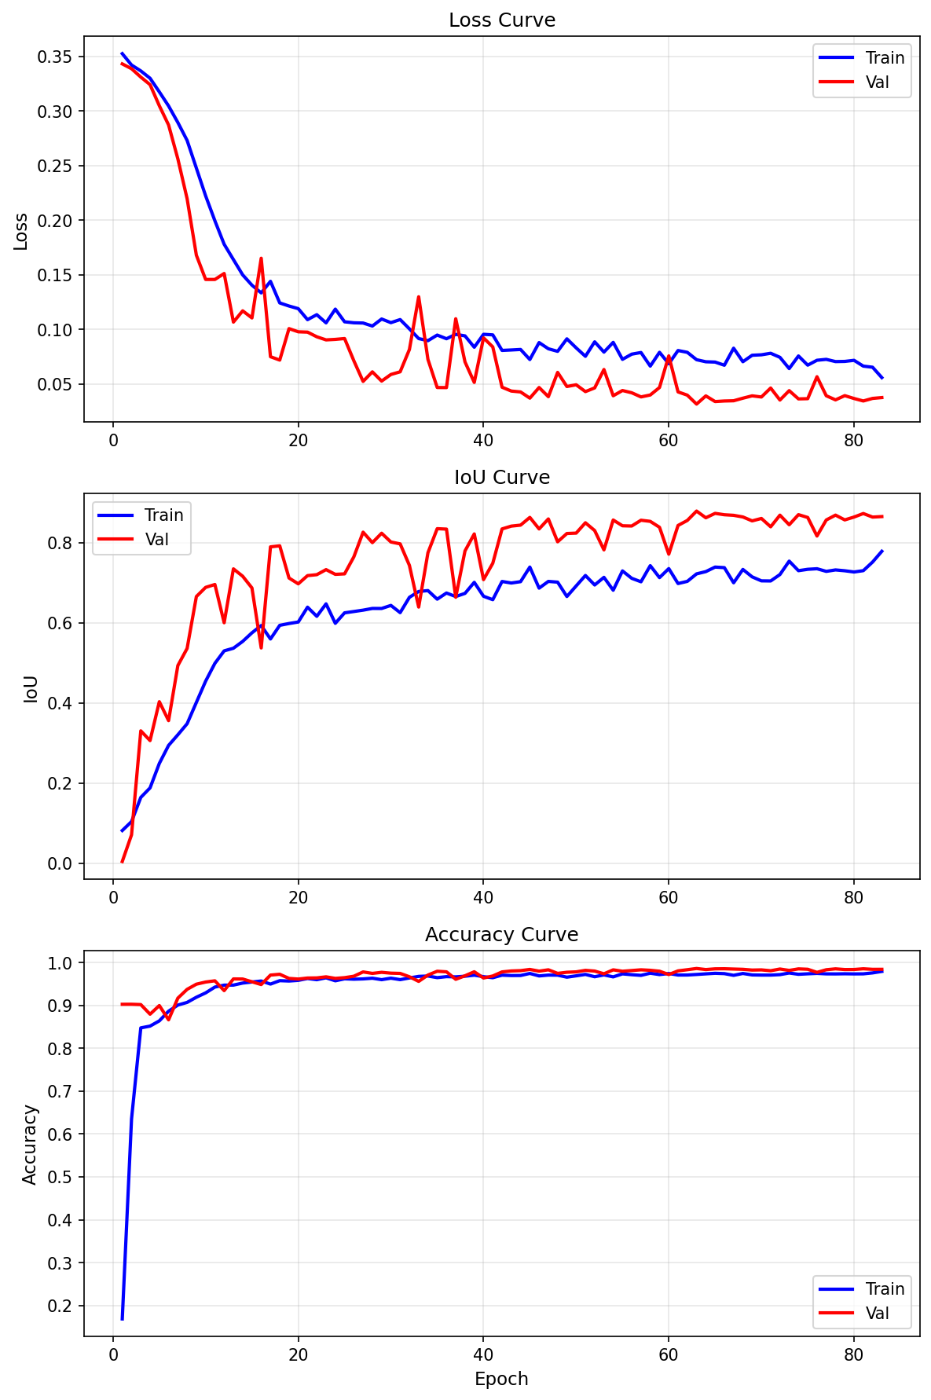
py_scripts/figure/20260416_223257_UNetMiniExp5_KD/training_curves.png
