AishuaiYao/AICleanBot/py_scripts/figure/20260416_224745_UNetMiniExp5/training_curves.png

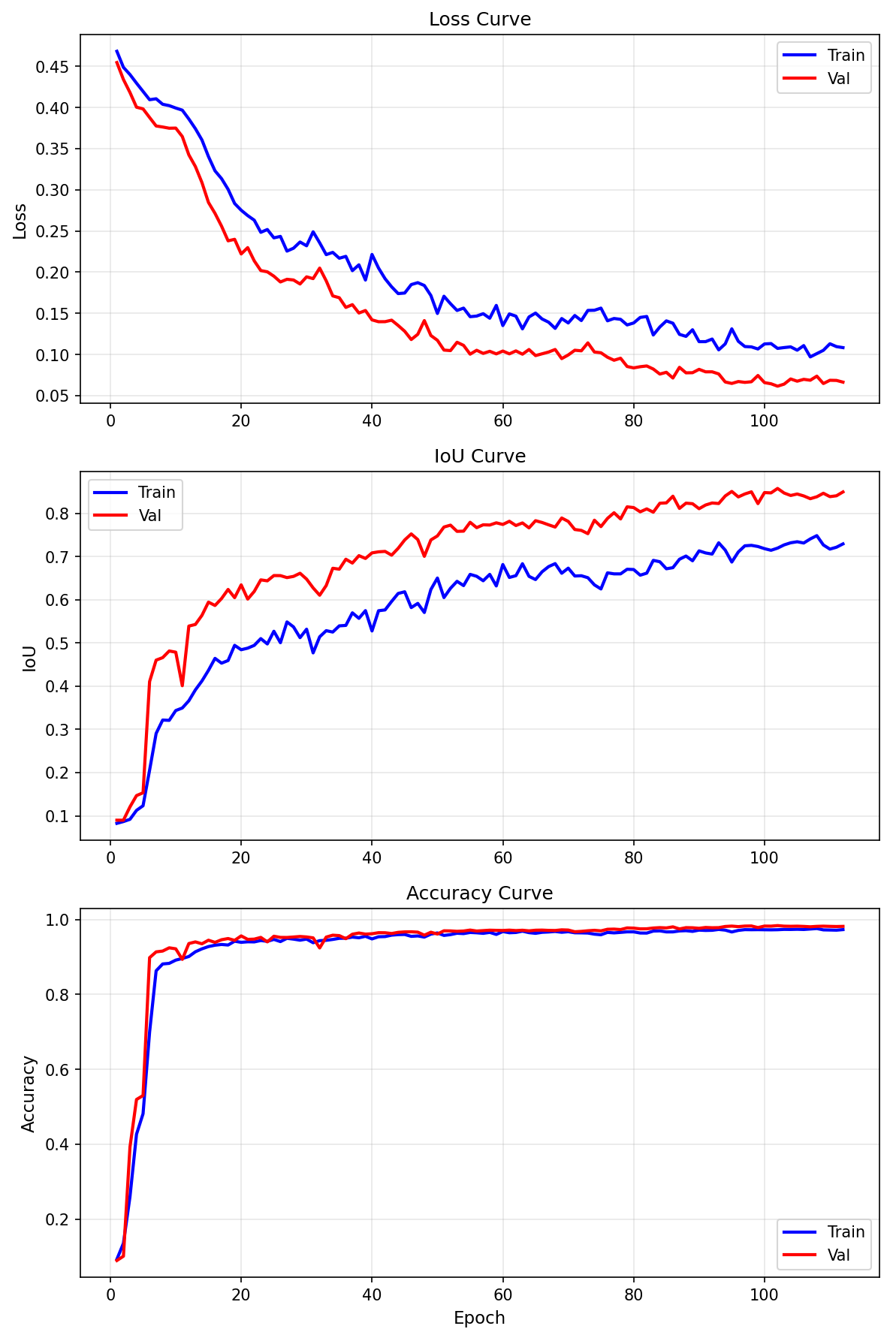
py_scripts/figure/20260416_224745_UNetMiniExp5/training_curves.png
