AishuaiYao/AICleanBot/py_scripts/figure/20260416_225153_UNetMiniExp5_KD/training_curves.png

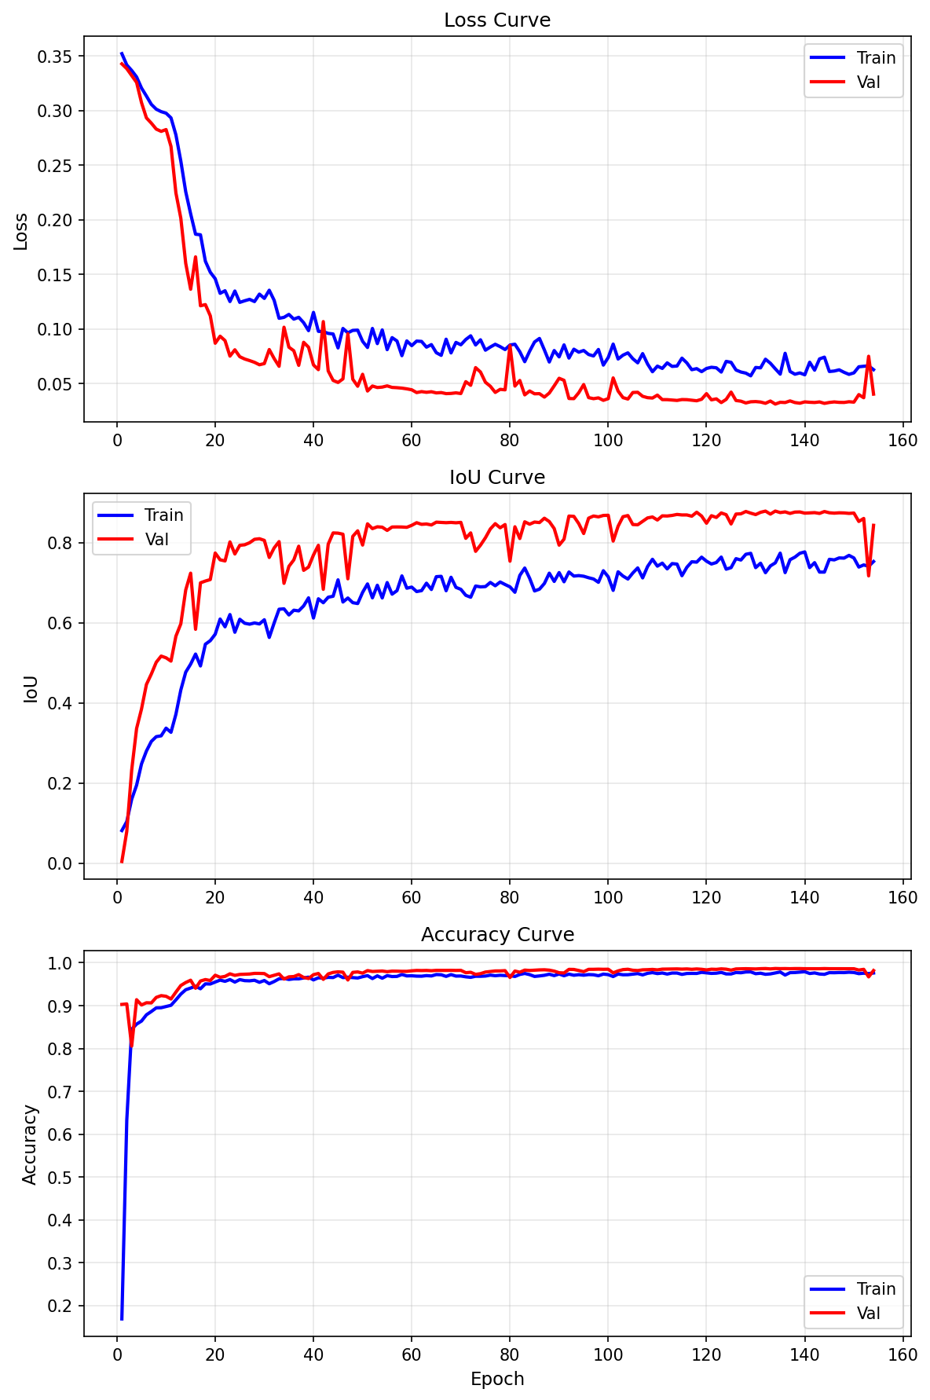
py_scripts/figure/20260416_225153_UNetMiniExp5_KD/training_curves.png
