AishuaiYao/AICleanBot/py_scripts/figure/capture_20260325_090952.jpg

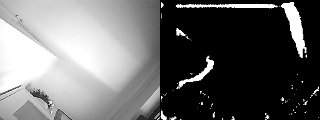
py_scripts/figure/capture_20260325_090952.jpg
