AishuaiYao/AICleanBot/py_scripts/figure/esp32log_overview.png

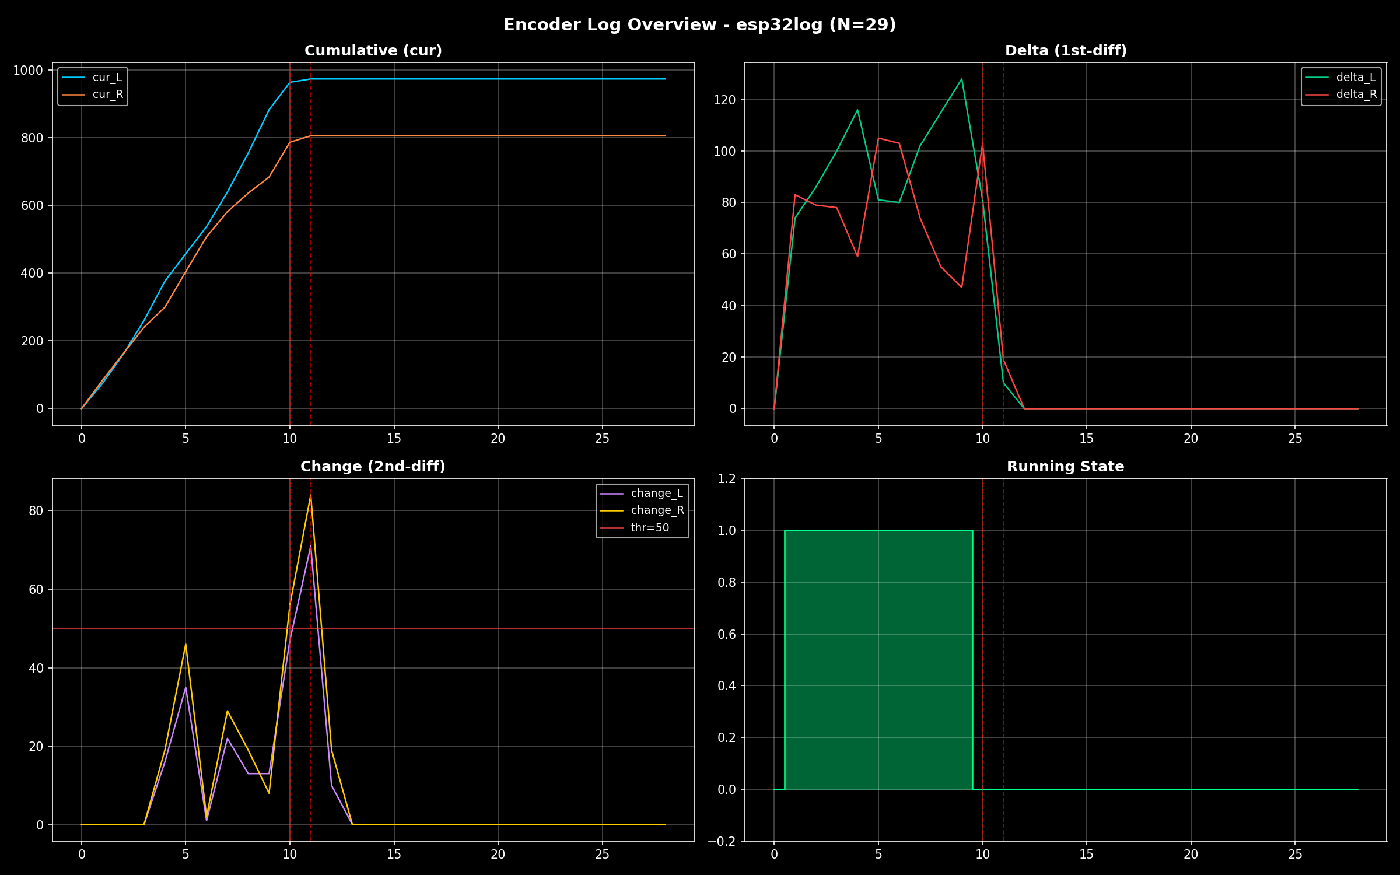
py_scripts/figure/esp32log_overview.png
