AishuaiYao/AICleanBot/py_scripts/figure/微信图片_20260325084154_36_2.jpg

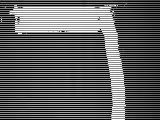
py_scripts/figure/微信图片_20260325084154_36_2.jpg
