AishuaiYao/AICleanBot/py_scripts/figure/编码器图表.png

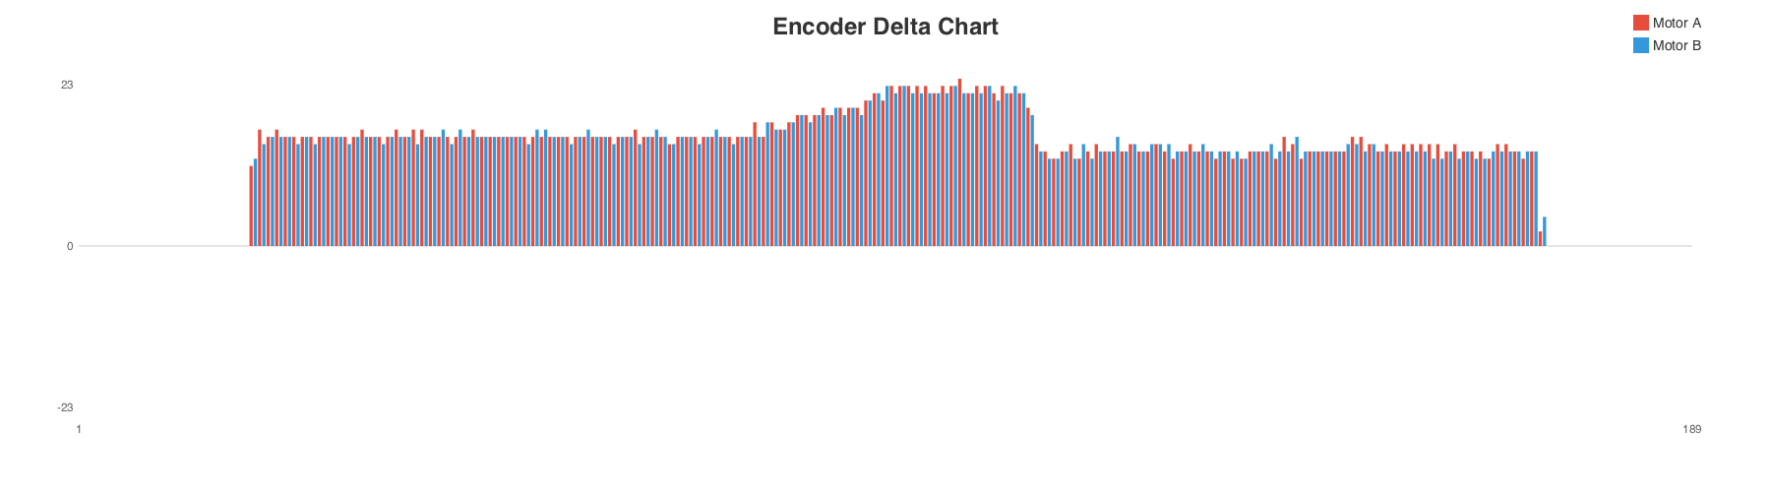
py_scripts/figure/编码器图表.png
