AishuaiYao/AICleanBot/hardware/bom.csv

序号 | 类别 | 型号规格 | 数量 | 备注
1 | 主控 | ESP32-S3-WROOM-1 N16R8 (8MB Flash + 8MB PSRAM) | 1 | 必须带 PSRAM
2 | 摄像头 | OV2640 24P 裸板 | 1 | 8位并口直连，无需 FIFO
3 | 电机驱动 | TB6612FNG 双路模块 | 1 | STBY 必须拉高
4 | 驱动电机 | JGA25-370 带 AB 相编码器 | 2 | 减速比 1:30 ~ 1:48
5 | 清洁电机 | 130/260 小型直流电机 | 1 | 固件中的 3 号电机
6 | 电池 | 3S 锂电池组 11.1~12.6V | 1 | 容量 >= 2000mAh
7 | 降压模块 | DC-DC 12V to 5V 2A | 1 | 供主控与逻辑侧
8 | 电阻 | 100k 欧姆 1% | 1 | 电池分压上臂
9 | 电阻 | 10k 欧姆 1% | 1 | 电池分压下臂
10 | 车体 | 3D 打印件 外壳+底盘+水箱 | 1套 | 见 hardware/cad
11 | 轮子 | 65~80mm 橡胶轮 | 2 | 压装到电机轴
12 | 万向轮 | 1~1.5 寸 | 1 | 后支撑
13 | 紧固件 | M3 螺丝螺母铜柱套装 | 1套
14 | 开关 | 自锁船型开关 10A | 1 | 串在电池正极
