AishuaiYao/AICleanBot/hardware/cad/chassis.stl

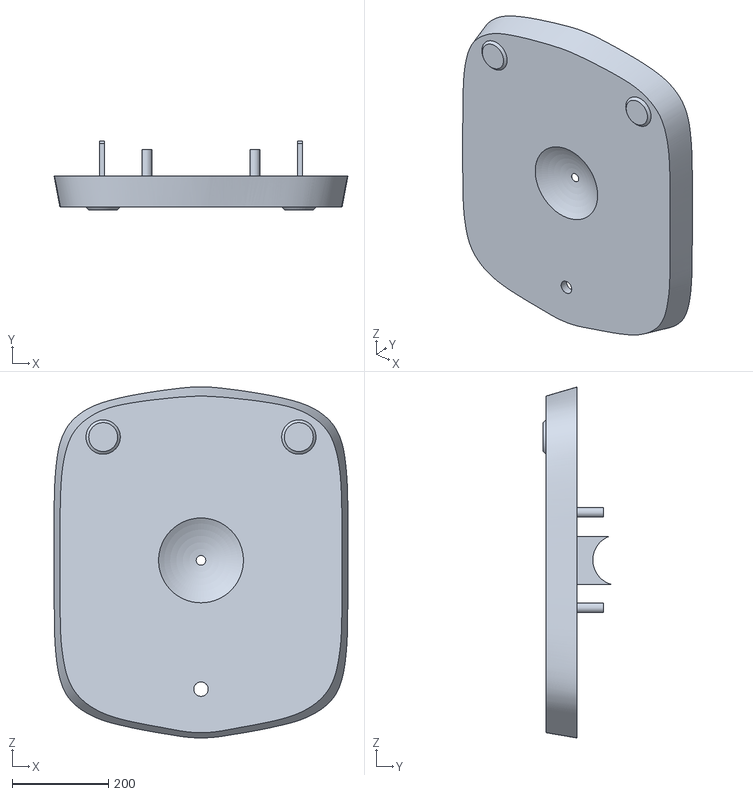
[picture p86: CAD file, 2026-10-21]
hardware/cad/chassis.stl
609.4 x 142.3 x 727.9
