AishuaiYao/AICleanBot/hardware/cad/water-tank.stl

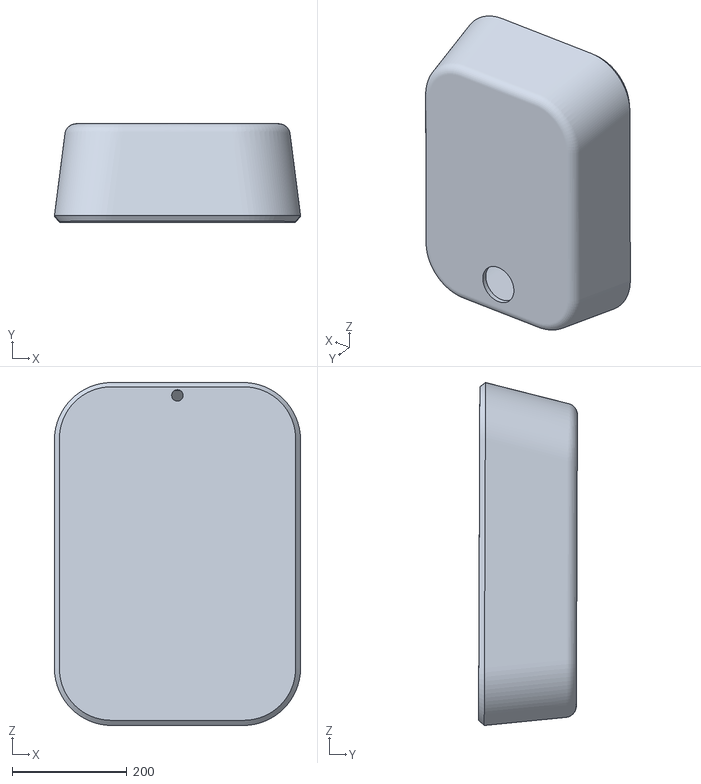
[picture p87: CAD file, 2026-10-21]
hardware/cad/water-tank.stl
428.2 x 172.0 x 596.5
