AishuaiYao/AICleanBot/hardware/cad/shell.stl

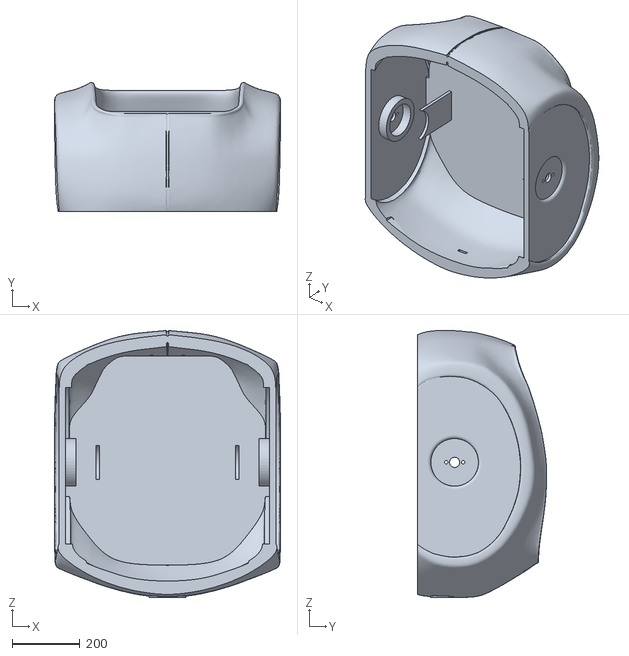
[picture p88: CAD file, 2026-10-21]
hardware/cad/shell.stl
666.3 x 380.9 x 785.8
