AishuaiYao/AICleanBot/docs/assets/img/board-wiring-1.jpg

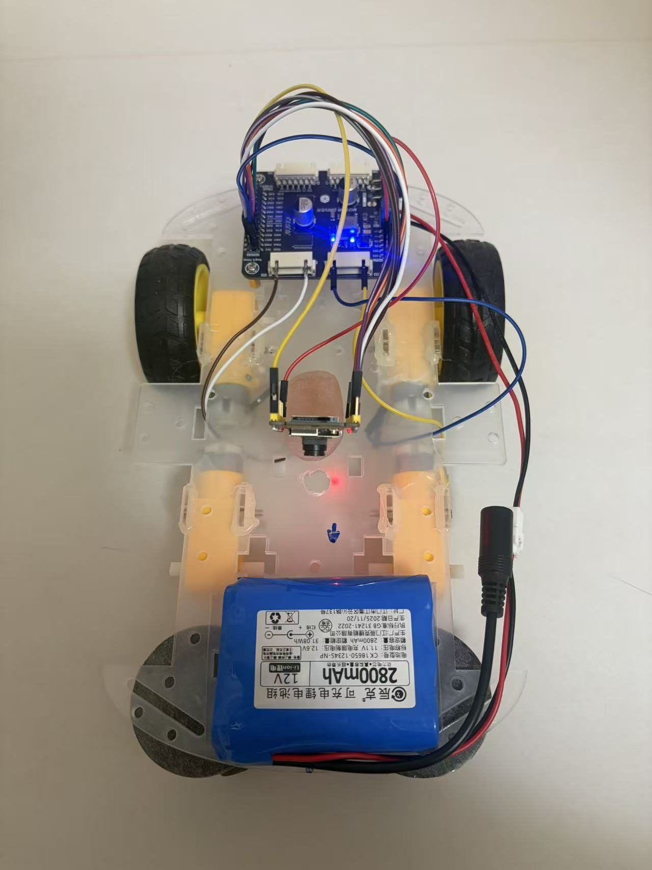
docs/assets/img/board-wiring-1.jpg
