AishuaiYao/AICleanBot/docs/assets/img/print-1.jpg

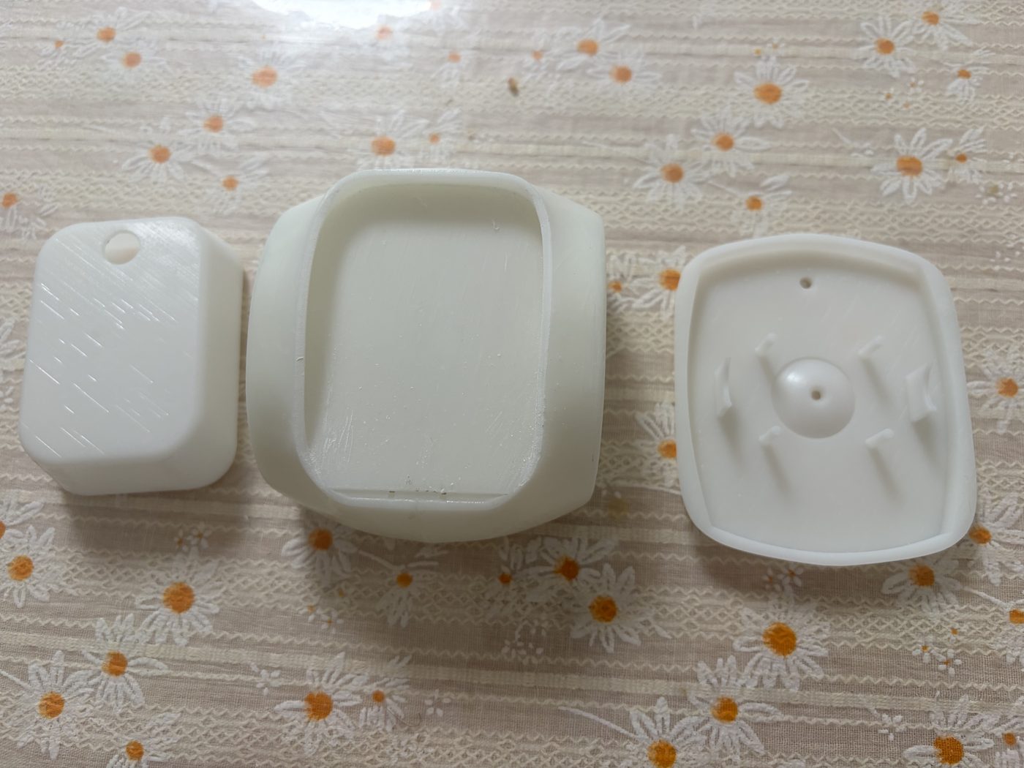
docs/assets/img/print-1.jpg
