AishuaiYao/AICleanBot/docs/assets/img/print-3.jpg

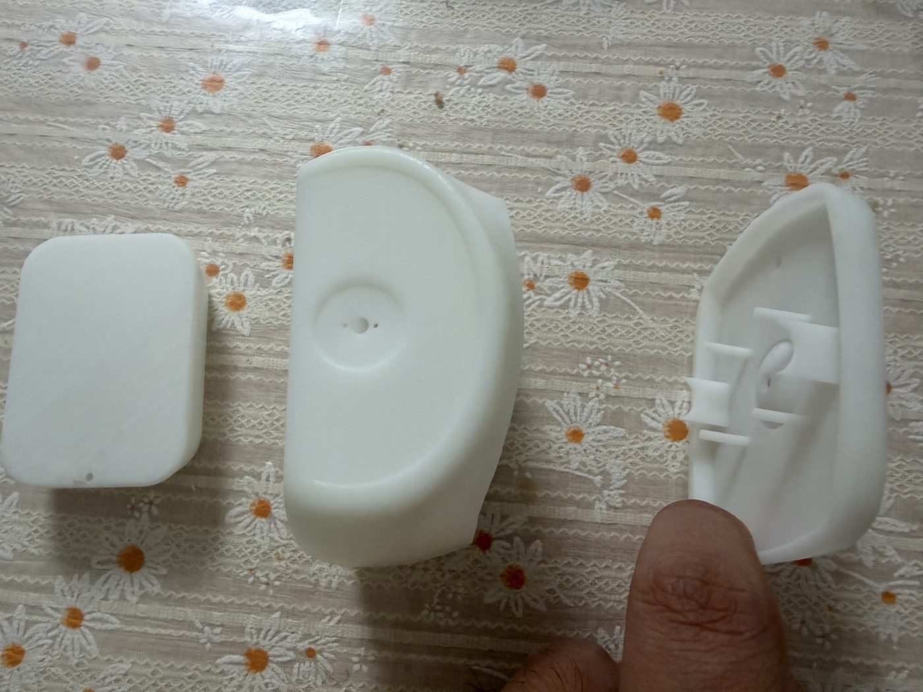
docs/assets/img/print-3.jpg
