AishuaiYao/AICleanBot/hardware/photos/board-wiring-3.jpg

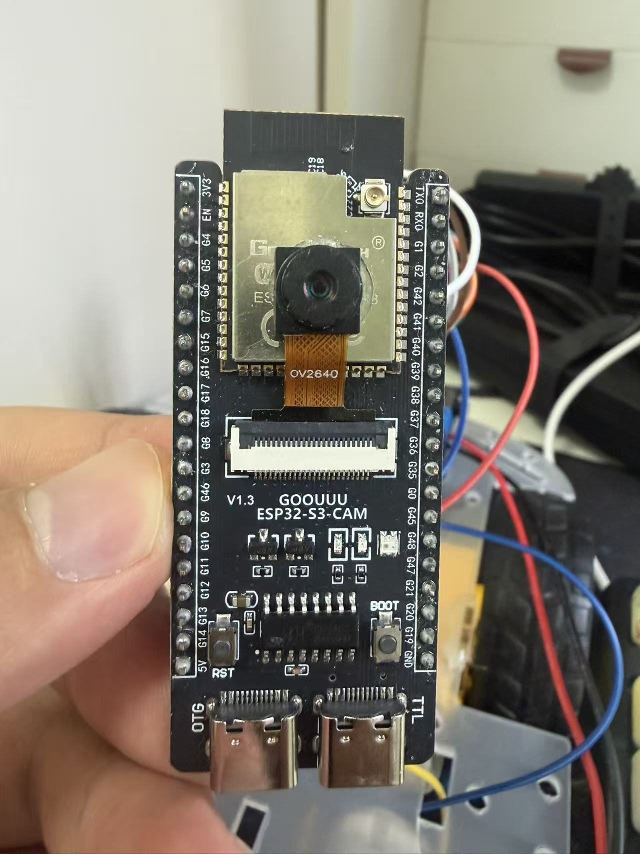
hardware/photos/board-wiring-3.jpg
