AishuaiYao/AICleanBot/py_scripts/utils/test_images/00007.png

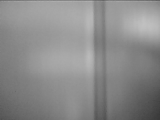
py_scripts/utils/test_images/00007.png
