AishuaiYao/AICleanBot/py_scripts/utils/test_images/00013.png

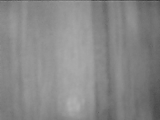
py_scripts/utils/test_images/00013.png
