AishuaiYao/AICleanBot/py_scripts/utils/test_images/00174.png

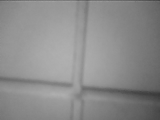
py_scripts/utils/test_images/00174.png
