AishuaiYao/AICleanBot/py_scripts/utils/test_images/00390.png

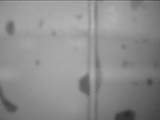
py_scripts/utils/test_images/00390.png
