AishuaiYao/AICleanBot/py_scripts/utils/test_images/00560.png

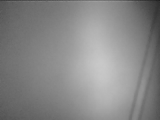
py_scripts/utils/test_images/00560.png
