AishuaiYao/AICleanBot/py_scripts/utils/test_images/00566.png

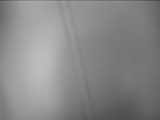
py_scripts/utils/test_images/00566.png
