AishuaiYao/AICleanBot/py_scripts/utils/test_images/00594.png

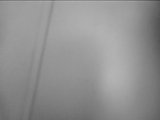
py_scripts/utils/test_images/00594.png
