AishuaiYao/AICleanBot/py_scripts/utils/test_results/00002_concat.png

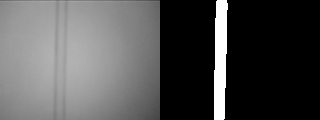
py_scripts/utils/test_results/00002_concat.png
