AishuaiYao/AICleanBot/py_scripts/utils/test_results/00007_concat.png

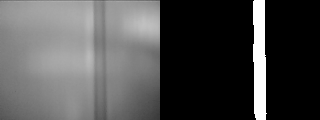
py_scripts/utils/test_results/00007_concat.png
