AishuaiYao/AICleanBot/py_scripts/utils/test_results/00008_concat.png

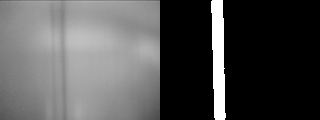
py_scripts/utils/test_results/00008_concat.png
