AishuaiYao/AICleanBot/py_scripts/utils/test_results/00009_concat.png

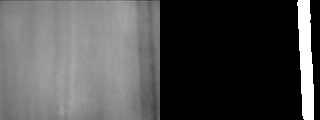
py_scripts/utils/test_results/00009_concat.png
