AishuaiYao/AICleanBot/py_scripts/utils/test_results/00057_concat.png

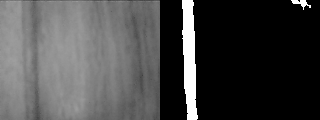
py_scripts/utils/test_results/00057_concat.png
