AishuaiYao/AICleanBot/py_scripts/utils/test_results/00208_concat.png

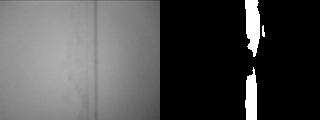
py_scripts/utils/test_results/00208_concat.png
