AishuaiYao/AICleanBot/py_scripts/utils/test_results/00315_concat.png

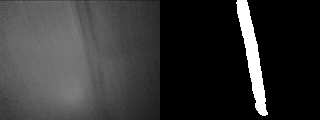
py_scripts/utils/test_results/00315_concat.png
