AishuaiYao/AICleanBot/py_scripts/utils/test_results/00316_concat.png

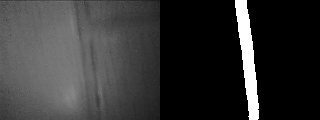
py_scripts/utils/test_results/00316_concat.png
