AishuaiYao/AICleanBot/py_scripts/utils/test_results/00323_concat.png

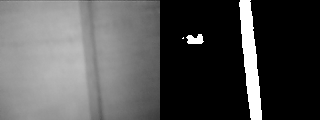
py_scripts/utils/test_results/00323_concat.png
