AishuaiYao/AICleanBot/py_scripts/utils/test_results/00364_concat.png

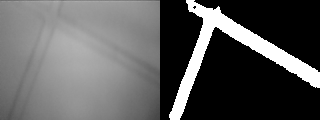
py_scripts/utils/test_results/00364_concat.png
