AishuaiYao/AICleanBot/py_scripts/utils/test_results/00365_concat.png

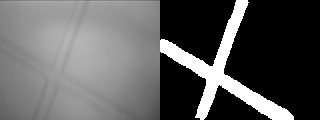
py_scripts/utils/test_results/00365_concat.png
