AishuaiYao/AICleanBot/py_scripts/utils/test_results/00368_concat.png

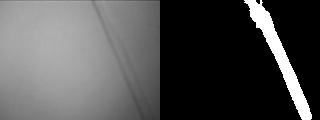
py_scripts/utils/test_results/00368_concat.png
