AishuaiYao/AICleanBot/py_scripts/utils/test_results/00419_concat.png

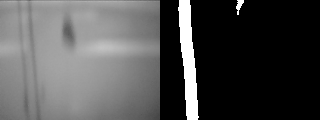
py_scripts/utils/test_results/00419_concat.png
