AishuaiYao/AICleanBot/py_scripts/utils/test_results/00420_concat.png

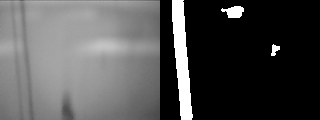
py_scripts/utils/test_results/00420_concat.png
