AishuaiYao/AICleanBot/py_scripts/utils/test_results/00424_concat.png

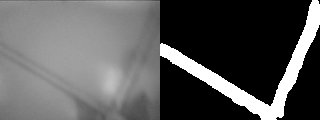
py_scripts/utils/test_results/00424_concat.png
