AishuaiYao/AICleanBot/py_scripts/utils/test_results/00439_concat.png

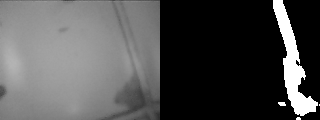
py_scripts/utils/test_results/00439_concat.png
