AishuaiYao/AICleanBot/py_scripts/utils/test_results/00455_concat.png

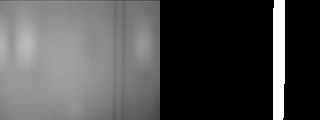
py_scripts/utils/test_results/00455_concat.png
