AishuaiYao/AICleanBot/py_scripts/utils/test_results/00544_concat.png

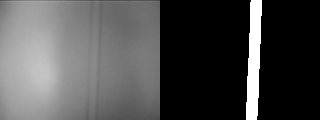
py_scripts/utils/test_results/00544_concat.png
