AishuaiYao/AICleanBot/py_scripts/utils/test_results/00545_concat.png

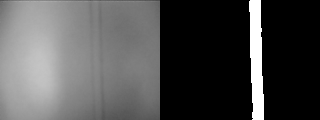
py_scripts/utils/test_results/00545_concat.png
