AishuaiYao/AICleanBot/py_scripts/utils/test_results/00546_concat.png

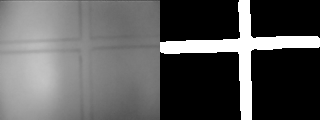
py_scripts/utils/test_results/00546_concat.png
