AishuaiYao/AICleanBot/py_scripts/utils/test_results/00550_concat.png

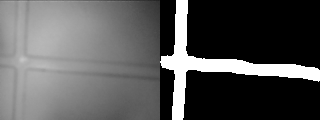
py_scripts/utils/test_results/00550_concat.png
