AishuaiYao/AICleanBot/py_scripts/utils/test_results/00560_concat.png

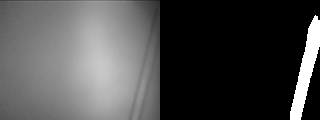
py_scripts/utils/test_results/00560_concat.png
