AishuaiYao/AICleanBot/py_scripts/utils/test_results/00567_concat.png

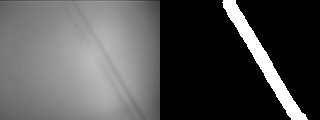
py_scripts/utils/test_results/00567_concat.png
