AishuaiYao/AICleanBot/py_scripts/utils/test_results/00582_concat.png

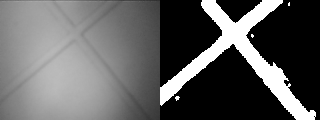
py_scripts/utils/test_results/00582_concat.png
