AishuaiYao/AICleanBot/py_scripts/utils/test_results/00583_concat.png

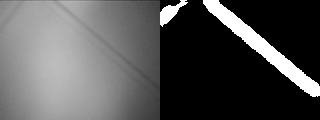
py_scripts/utils/test_results/00583_concat.png
