AishuaiYao/AICleanBot/py_scripts/utils/test_results/00586_concat.png

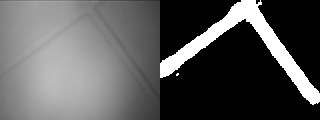
py_scripts/utils/test_results/00586_concat.png
