AishuaiYao/AICleanBot/py_scripts/utils/test_results/00589_concat.png

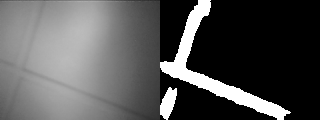
py_scripts/utils/test_results/00589_concat.png
