AishuaiYao/AICleanBot/py_scripts/utils/test_results/00594_concat.png

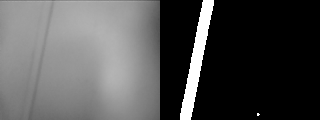
py_scripts/utils/test_results/00594_concat.png
