AishuaiYao/AICleanBot/py_scripts/figure/aug_debug_batch.jpg

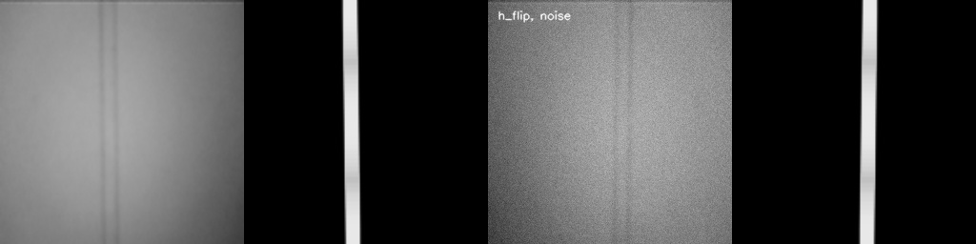
py_scripts/figure/aug_debug_batch.jpg
