AishuaiYao/AICleanBot/main/model_data.h

#ifndef MODEL_DATA_H
#define MODEL_DATA_H

#include <stdint.h>
#include <stddef.h>


const uint8_t model_data[] = {
    0x45, 0x44, 0x4c, 0x32, 0x00, 0x00, 0x00, 0x00, 0xe0, 0x1d, 0x00, 0x00, 0x00, 0x00, 0x00, 0x00,
    0x24, 0x00, 0x00, 0x00, 0x00, 0x00, 0x00, 0x00, 0x00, 0x00, 0x00, 0x00, 0x00, 0x00, 0x00, 0x00,
    0x14, 0x00, 0x10, 0x00, 0x04, 0x00, 0x08, 0x00, 0x00, 0x00, 0x00, 0x00, 0x00, 0x00, 0x00, 0x00,
    0x00, 0x00, 0x0c, 0x00, 0x14, 0x00, 0x00, 0x00, 0x07, 0x00, 0x00, 0x00, 0x08, 0x00, 0x00, 0x00,
    0x20, 0x00, 0x00, 0x00, 0x00, 0x00, 0x00, 0x00, 0x18, 0x00, 0x24, 0x00, 0x10, 0x00, 0x0c, 0x00,
    0x20, 0x00, 0x00, 0x00, 0x08, 0x00, 0x04, 0x00, 0x1c, 0x00, 0x00, 0x00, 0x18, 0x00, 0x14, 0x00,
    0x18, 0x00, 0x00, 0x00, 0x20, 0x00, 0x00, 0x00, 0x24, 0x00, 0x00, 0x00, 0x78, 0x00, 0x00, 0x00,
    0x24, 0x00, 0x00, 0x00, 0x30, 0x00, 0x00, 0x00, 0x34, 0x00, 0x00, 0x00, 0x38, 0x00, 0x00, 0x00,
    0x48, 0x00, 0x00, 0x00, 0x01, 0x00, 0x00, 0x00, 0x84, 0x04, 0x00, 0x00, 0x01, 0x00, 0x00, 0x00,
    0x5c, 0x16, 0x00, 0x00, 0x03, 0x00, 0x00, 0x00, 0xe0, 0x1b, 0x00, 0x00, 0x6c, 0x1a, 0x00, 0x00,
    0x18, 0x19, 0x00, 0x00, 0x01, 0x00, 0x00, 0x00, 0x4c, 0x00, 0x00, 0x00, 0x01, 0x00, 0x00, 0x00,
    0xc4, 0x00, 0x00, 0x00, 0x04, 0x00, 0x00, 0x00, 0xc4, 0x16, 0x00, 0x00, 0x30, 0x16, 0x00, 0x00,
    0x4c, 0x04, 0x00, 0x00, 0x90, 0x01, 0x00, 0x00, 0x06, 0x00, 0x00, 0x00, 0x84, 0x17, 0x00, 0x00,
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
    0x6c, 0x00, 0x00, 0x00, 0x01, 0x00, 0x00, 0x00, 0xfa, 0xff, 0xff, 0xff, 0xff, 0xff, 0xff, 0xff,
    0xd8, 0xea, 0xff, 0xff, 0x08, 0x00, 0x00, 0x00, 0x00, 0x00, 0x00, 0x01, 0xd0, 0xea, 0xff, 0xff,
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
};


const size_t model_data_size = sizeof(model_data);

#endif // MODEL_DATA_H
