AishuaiYao/AICleanBot/(commit log)

2026-02-19 AI清洁机器人初始文件
2026-02-19 测试vscode
2026-02-27 添加esp32官方神经网络量化demo
2026-02-27 实验将demo网络烧录到板子上
2026-03-01 实验将demo网络烧录到板子上-增加c++代码
2026-03-05 定位编译报错不一致问题
2026-03-06 加入路径规划模拟软件
2026-03-08 还未编译成功-周日备份
2026-03-08 将esp-dl组件移除能编译成功，并且实现了一次实验
2026-03-09 main改为真实使用esp dl
2026-03-09 备份espdl的报错到log1
2026-03-15 解决了bootloader报错问题，方法是将esp-dl目录与esp-idf目录分开
2026-03-15 优化目录结构
2026-03-15 更新prompt
2026-03-15 完善标注工具
2026-03-15 添加可视化label的方法
2026-03-16 新增teacher和student
2026-03-18 更新了路径规划模拟，增加了场景分类模拟
2026-03-18 实现C++的图像获取功能
2026-03-21 训练过程增加数据增强
2026-03-21 修复标注工具空格不计数问题
2026-03-21 测试连接微信小程序
2026-03-21 增加早停逻辑
2026-03-21 修复打标工具enter键的bug
2026-03-21 使用focal loss
2026-03-21 完善了学生网络生成了500k和1m的两个模型
2026-03-23 可以通过ap模式与小程序连接
2026-03-25 实验：图像采集+语义分割+回传小程序
2026-03-25 实验：图像采集+语义分割+回传小程序—exp1 日志和图像
2026-03-25 实验：图像采集+语义分割+回传小程序—exp1 日志和图像 小程序有问题
2026-03-26 优化了没必要的resize ，增加了打印参数量和计算量方法
2026-03-26 耗时实验：增加可分离卷积结构-将onnx转换的方法提到了tools。修改了所有resize逻辑
2026-03-26 耗时实验：增加可分离卷积结构-update
2026-03-28 耗时实验：增加可分离卷积结构-Nearest
2026-03-28 耗时实验：增加可分离卷积结构-sigmoid
2026-03-28 使用双核心，将模型推理放在core1
2026-03-28 LTO优化
2026-03-28 耗时实验：增加可分离卷积结构-增加了exp5和6两个实验，将通道数改为8的倍数提升效果明显
2026-03-29 耗时实验：增加可分离卷积结构-增加了exp7实验普通卷积8的倍数
2026-03-30 网络连接实验-握手连接
2026-03-30 网络连接实验-去重连接
2026-04-02 网络连接实验-数据采集
2026-04-04 网络连接实验-数据采集一个跑通的baseline
2026-04-04 网络连接实验-baseline提高包大小到8000字节
2026-04-06 打印电机控制
2026-04-08 点击控制实验-baseline
2026-04-09 电机初步控制，参数不太合理
2026-04-11 start和speed合并
2026-04-11 电机控制基本符合预期
2026-04-11 修复了退出界面UDP仍持续发送数据的问题
2026-04-11 支持回传电机pwm值功能
2026-04-11 增加快速测试模型的测试代码
2026-04-11 增加相关数据采集和模型推理测试的代码注释
2026-04-11 优化项目结构
2026-04-12 增加训练曲线图表
2026-04-12 增加日志自动保存
2026-04-12 量化实验
2026-04-12 量化过程保存日志
2026-04-12 量化过程保存日志-添加随机种子
2026-04-12 量化过程保存日志-使用真实数据做量化误差评估
2026-04-12 量化过程使用真实数据
2026-04-12 c++端对齐训练阶段预处理等逻辑
2026-04-13 预测结果使用反量化
2026-04-13 增加一些效果图表
2026-04-14 余弦退火重启
2026-04-15 上传dataset
2026-04-15 去掉dice
2026-04-15 上传label
2026-04-15 使用focalloss+diceloss，提升明显
2026-04-15 将数据切分为train和val
2026-04-15 优化了训练集的组织结构
2026-04-16 同步了老师模型脚本训练逻辑
2026-04-16 老师模型-使用预训练模型，是所有模型里目前效果最好的
2026-04-16 修改inference适配teacher
2026-04-16 知识蒸馏-仅仅余弦退火
2026-04-17 知识蒸馏--同步效果和日志
2026-04-22 更新硬件减速电机每分钟60转，对应更新pwm波范围从最高20提高到100
2026-04-23 更新电机驱动以及编码器脉冲获取
2026-04-28 加入编码器
2026-04-28 引脚定义不会引起重启问题，但编码器的结果为0
2026-05-06 有一次引起重启问题
2026-05-06 修复了重启问题，没有使能pcnt
2026-05-06 仍在尝试读取编码器的值
2026-05-08 定位到了编码器问题，原因是没有电池的情况下，从开发板引入电源的时候连接了5v电源
2026-05-08 新的问题，手动转轮的编码器值很奇怪
2026-05-10 解决了，原因是vcc和gnd因为排线固定，接线错误
2026-05-10 编码器基础实验ok
2026-05-10 电机编码器测试代码-两倍频正值正转负值反转
2026-05-10 小程序可以读取到编码器的值了
2026-05-10 编码器功能实现base
2026-05-11 能够正确读取压值
2026-05-11 能够正确读取压值-删除循环打印压值
2026-05-11 更新readme
2026-05-12 添加呼吸灯
2026-05-13 量化分析临时上传模型
2026-05-14 优化了单独测试模型推理的实验
2026-05-17 优化了推理逻辑（预处理和后处理等）
2026-05-17 增加实验场景相关代码
2026-05-18 修复了实验场景的图像错位问题
2026-05-19 实验场景增加推理和耗时打印
2026-05-20 实验场景增加kp控制
2026-05-23 kp控制-error=交点x-targetx
2026-05-23 去掉了一些冗余逻辑
2026-05-24 叠加显示
2026-05-26 保存udp现状
2026-05-26 实验场景改为tcp传输画面，不在卡顿
2026-05-28 分段函数
2026-05-30 分段函数优化逻辑：仅当 | G1-G2|≥10 时生效，其余情况放宽控制条件以提升合理性
2026-06-02 将编码器日志保存到云端，然后拷贝分析
2026-06-03 一个可用的base版的碰撞检测，根据当前增量与前10帧增量均值作比较，看有没有掉速，阈值为掉速到原来的80%
2026-06-04 碰撞检测改为两轮同时降速，防止pid调速误判
2026-06-06 OTA实验ok，不过就是目前有权限问题
2026-06-06 通过云函数绕开了OTA权限问题
2026-06-06 优化了wifi账号密码
2026-06-21 电机3使能成功
2026-06-27 降低占空比
2026-10-21 添加 smartcat 上位机端子模块
    将微信小程序上位机端代码 smartcat 以 git submodule 形式接入项目
2026-10-21 开源整理：消除本地路径、补齐依赖与许可
    1. Python 脚本路径改为基于 __file__ 推导，仓库可放到任意目录
    2. 移除 idf_component.yml 中写死的 esp-dl override_path
    3. gitignore 放开编译必需的 main/models/model.espdl
    4. dependencies.lock 含本地路径，移出版本控制
    5. requirements.txt 补齐 esp-ppq / onnxruntime 并加安装说明
    6. 删除与本项目无关的个人脚本与 prompt.txt
    7. 新增 Apache-2.0 LICENSE、NOTICE、CONTRIBUTING.md
2026-10-21 新增硬件资料、项目官网与社区模板
    1. hardware/：BOM、原理图、TB6612 手册、嘉立创工程、STL 模型、实拍与装配说明
    2. docs/：深色风格项目官网，含演示视频、架构、硬件图集、Roadmap
    3. .github/：Issue 表单、PR 模板、Pages 自动部署 workflow
    4. ROADMAP.md：V1 ~ V4 公开路线与待协作项
    5. README 重写：加实拍图、官网链接、硬件章节与完整复现步骤
    6. main/models/model.espdl 纳入版本控制，保证克隆后可编译
2026-10-21 更新 smartcat 子模块指针（新增 UI 截图）
2026-10-21 脱敏：所有密码与凭据改为占位符
    1. main/app_main.cpp、main/inference_test.cpp 的 AP_PASSWORD 改为 ********
    2. py_scripts/utils/capture_img_serve.py 的 AP_PASSWORD 改为 ********
    3. smartcat 的 AppID、微信云环境 ID、云存储 bucket 前缀改为占位符
    4. smartcat/log.txt 热点密码脱敏，README 本地绝对路径改为相对路径
    5. README / 官网补充说明：烧录前须自行设置密码
    6. PR 模板增加禁止提交凭据明文的检查项
    用 8 位星号而非 2 位，因为 esp_wifi_start() 对短于 8 位的密码会返回 ESP_ERR_WIFI_PASSWORD
2026-10-21 新增 SECURITY.md：漏洞报告流程与凭据占位符说明
2026-10-21 官网：修复主图变形、裁掉 AI 水印、移除早期草图
    1. .hero-visual img 补 width:100%/height:auto，修复 img 的 height 属性硬撑导致的纵向拉伸
    2. 主图上下各裁一刀（1400x1400 -> 1400x925），去掉左上 AI生成 徽标与右下 即梦AI 水印
    3. 画廊移除早期草图并删除对应图片，HTML 的 width/height 同步更新为 1400x925
2026-10-22 README：补充实测指标、代码导览与引用信息
    1. 新增『实测指标』：教师/学生/蒸馏学生的真实 Best val IoU（取自 logs/ 训练日志），
    并说明板端速度需自行实测（串口每 100 帧打印各阶段耗时），不写死数字
    2. 新增『代码导览（固件）』：给出 app_main/handle_client 等关键函数的行号与常见改法
    3. 新增『引用』小节与 CITATION.cff（GitHub 会显示 Cite this repository）
    4. 开头补充：仓库自带 262 张标注数据与预训练模型，链路任意一环可单独跑
    5. 目录同步，致谢补充 PyTorch / MicroPython
2026-10-24 重构 utils：抽公共图片枚举函数，标注工具不再覆盖彩色原图
    1. tools.py 新增 list_images()，统一 jpg/jpeg/png/bmp 查找逻辑，
    替换 visualize_labels 与 split_dataset 中各自复制的 glob 模式
    2. label_tool.py 主流程包进 main() 并加 __main__ 守卫，现在可被 import 复用
    （draw_thick_line_on_single_channel 对外可用），导入时不再弹窗
    3. 标注工具不再无条件覆盖原图：彩色原图的灰度版改写到 FRAME_QQVGA_gray/，
    原图本就是灰度时仍写回原目录（行为不变且无损）
    4. README 同步：新增产物落盘表格、FAQ 条目改写、工具速查表补充
2026-10-25 新增英文版 README 与中英切换入口
    1. 新增 README_EN.md（965 行），完整镜像中文版：硬件 BOM 与引脚表、两条上手路线、
    TCP/UDP 协议、训练与量化流程、实测指标、排障 FAQ、Roadmap、引用与许可证
    2. 中英双版顶部各加切换链接（English | 简体中文）
    3. 英文版同步本次重构：list_images、label_tool 产物落盘规则、固件代码导览
2026-10-27 fix(ota): 加固 OTA 升级链路，避免刷坏与链路必失败
    固件端 (main/app_main.cpp):
    - esp_ota_begin 前校验固件大小(>0 且不超过 OTA 分区容量)，非法直接拒收
    - 接收缓冲 malloc 判空，OOM 时 abort 而非空指针写
    - 接收/写入/结束失败一律 esp_ota_abort，避免分区处于中间态
    - 每收满 16KB 回 OTA_ACK，供发送端做流控与判活，不再盲发
    - OTA:START 的大小字段改用 strtol 严格解析，非数字/<=0 直接拒绝
    - 启动后调用 esp_ota_mark_app_valid_cancel_rollback 配合回滚
    sdkconfig: 开启 CONFIG_BOOTLOADER_APP_ROLLBACK_ENABLE，新固件起不来自动回滚
    小程序子模块: 修复云函数只认 fil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
2026-10-29 fix(log): 修正 snprintf 长度被当发送长度导致的缓冲区越界
    snprintf 返回的是未截断长度，直接用作 send 长度在格式化被截断时会读越界；
    实验模式编码器日志还用 strcat 追加换行，截断时会向缓冲区外多写 1 字节。
    - 新增 SNPRINTF_LEN 宏统一把返回值钳到缓冲区容量内(预留一位给换行)
    - 编码器日志改为在有效长度末尾直接写 '\n'，去掉 strcat
    - OTA 的 begin_err/OTA_PROGRESS/OTA_ACK 三处同样改用 SNPRINTF_LEN
2026-10-29 chore: 更新小程序子模块指针至 3bcf712
    同步小程序主界面优化：空状态提示、跳转参数 encodeURIComponent、
    移除设备二次确认、握手响应解析改用 fromCharCode.apply
2026-10-31 perf(preprocess): 输入量化改用 256 字节查表
    预处理循环每帧要对 19200 个像素做浮点归一化、量化、取整和钳位，
    和后处理已有的 sigmoid 查表思路不一致。
    - 启动时按输入 tensor 的量化参数构建 input_quant_lut[256]
    - experiment_stream 与 CAPTURE 两条路径的预处理都改为一次查表
    - 逐像素结果与原先完全一致（沿用同一 DL_CLIP/dl::tool::round 表达式）
2026-10-31 perf(utils): 收包改为分块拼接，避免 O(n^2) 内存拷贝
    bytes 的 `+=` 每 recv 一次就整块重拷贝，一帧要 recv 数十次，
    累计拷贝量随帧长平方增长；改用列表收集后 b''.join 一次成型。
    返回值、超时与错误分支行为不变，无新增依赖。
2026-11-05 fix(mem): 补齐主循环三处 malloc 判空，消除 OOM 时空指针写
    - CAPTURE 分支: pred_data / concat_data 分配失败时释放已持有资源、
    归还摄像头帧并跳过本帧，不再向空指针写入
    - UDP 分帧发送: chunk_buf 判空从写入之后提前到 malloc 之后
    (原代码先写 chunk_buf[4..10] 再判空，判空形同虚设)，失败跳过该分片
2026-11-08 perf(stream): 图像流发送缓冲改为会话级复用，消除每帧 malloc/free
    - experiment_stream: send_buf(19210B) 提前到流开始前一次性分配，
    分配失败与 STOP_EXPERIMENT 两处退出路径均释放；主循环内不再 malloc/free
    - STREAM: 三个 UDP 分片共用一个 8011B 缓冲(sendto 同步返回后即可复用)，
    容量覆盖首片 8011B / 中间片 8004B / 末片 3204B；流循环结束后释放
    - 分配失败时复用已有的 "ERROR\n" 响应客户端，不再进入流循环
    - 修正 [Stream] 日志写死"分片数: 4"与 total_chunks=3 不一致，改为打印实际值
2026-11-08 fix(exp): TCP 整帧改为循环发送，消除短写导致的帧错位
    新增 send_all(): 单次 send() 允许短写，19210B 帧超过 lwIP MSS 时几乎必然只发出一部分，原来按 == frame_packet_size 判成功会丢帧并让接收端帧头错位；同时把 n==0 当失败，避免原地空转。
2026-11-08 fix(capture): 帧头与图像分块改用 send_all，消除短写与空转
    原代码 4B 帧头 send 完全不检查返回值；图像分块在 send 返回 0 时 offset 不前进会无限循环，且只按 <0 判失败。现统一用 send_all 写满每片，失败即退出循环并如实记录日志成败，释放路径保持不变。
2026-11-08 perf(stream): 编码器读取从每帧降为每 20 帧
    统计日志里的 encoder_read 每帧执行但结果只有 1/20 帧被用到。UDP 首片仍需每帧读取编码器值，PCNT 溢出清零时机不变，这里仅去掉日志专用的多余硬件访问。
2026-11-08 fix(adc): 电池电压读取检查结果并对 1 字节协议字段钳位
    adc_raw 未初始化，adc_oneshot_read 失败时会拿随机栈值算电压；现在失败时沿用上次有效值并只告警一次。另外满量程换算得 363(36.3V)，直接转 uint8_t 会回绕成 107(10.7V)，先钳到 255 再返回。典型 12V 换算仍是 120，不受影响。
2026-11-08 fix(utils): 客户端校验帧长上限，超时设置移出收包循环
    帧头 4B 大端长度一旦错位可解出 4GB 量级，原来会直接按此长度收包导致内存耗尽/挂起；现在拒绝 0 和 >2MB 的帧长并重新同步。另把 settimeout 提到循环外(整帧一次)、两处裸 except 收窄为 OSError。已用假 socket 验证非法帧长路径与正常收帧均符合预期。
2026-11-10 fix(tcp): 握手拒绝长度不足的短包并零初始化缓冲
    原判断只排除 len<=0，收到 1~4 字节时 strncmp(...,5) 会继续读未初始化的栈内容；同时把 handshake_buf 清零，让比较结果确定。
2026-11-10 fix(udp): 检查 getpeername 结果，避免把视频流发往未初始化的地址
    getpeername 失败时 tcp_client_addr 是未初始化栈内存，原代码仍会据此设置 g_udp_client_addr 并置 ready。现在失败即回复已有的 UDP_NOT_READY、清除 ready 并跳过本次设置；UDP_HELLO 其它失败路径也不再残留上次连接的目标地址。
2026-11-10 fix(net): 补齐 TCP 服务初始化返回值检查并清零地址结构
    tcp_server_task 原来对 socket/bind/listen 的返回值一概不检查，失败后会对无效 fd 反复 accept 空转；现在失败即关闭 fd 并退出任务，accept 连续失败时也让出 100ms。udp_init 与 tcp_server_task 的 sockaddr_in 改为零初始化，避免把未初始化的 sin_zero 传给内核。
2026-11-10 fix(tcp): 握手信息与编码器状态行改用 send_all
    这两条控制消息原本用裸 send 且不检查返回值，短写会让客户端解析到半截握手串(含多字节 emoji)或半行编码器状态。复用已有的 send_all 保证写满，发送长度仍受 SNPRINTF_LEN 约束，最坏情况恰好 160B 不越界。
2026-11-10 perf(serve): MicroPython 图像发送改为头帧分两次写出
    sendall(header + buf) 会为每帧额外分配并拷贝一整帧数据，在堆紧张的 MicroPython 上不划算。改为依次 sendall(header)、sendall(buf)，TCP 字节流顺序不变，客户端仍按 4B 长度+帧数据解析。已用假 socket 验证发送序列与帧计数不变。
